shenjin73/microduck-build/working-docs/hardware-open-questions.md

# 硬件待确认清单（HD-1910 / 主板 / 连接板 / 目标 / 资源 / CAD）

日期：2026-09-16
用途：把 `microduck-clone-validation-risk-plan.md` 第 7 节的 6 个问题，变成**可以直接发给
供应商、或自己逐项填答**的清单。每项都写明「为什么需要」与「通过标准」。

> **为什么这份清单重要：** Week 1/2/3 全部卡在这些答案上（Week 0.5 的算力问题已结案）。
> 具体地——**HD-1910 的协议不确定，就不要下单批量电机**；协议没过，后面 10 周全是空中楼阁。

## 回答进度

| 类别 | 项数 | 已确认 | 阻塞的后续阶段 |
|---|---:|---:|---|
| A. HD-1910 供应商问题 | 24 | 0 | **Week 1**（单电机 spike）→ Week 3（BAM 辨识）→ Week 6（runtime） |
| B. 自查决策项 | 5 | 1（B1 主板） | Week 0（边界冻结）、Week 2（MJCF）、Week 8–9（训练） |
| C. 机械 CAD / BOM | 4 | 0 | **Week 2**（机械参数测量） |

---

# A. 发给供应商的问题清单（HD-1910-C001）

> 已从资料图确认的**不用再问**：型号 `HD-1910-C001`、TTL 三线串行总线、电压 `4–8.4V`、
> 堵转 `9kg·cm@4.8V / 12kg·cm@6V`、空载速度 `0.139/0.111 s/60°`、堵转电流
> `1.2A@4.8V / 1.5A@6V`、额定电流 `500/690mA`、重量 `21±2g`、尺寸 `34×20×23mm`、
> PA+Fiber 外壳、双轴金属齿轮。
>
> **缺的是「怎么跟它说话」——协议与寄存器。** 这是 A 部分的全部内容。

## A1. 协议与物理层（5 项）

> 已核实的官方 runtime 事实（供对照）：
> `microduck/duck-control/src/model.rs:12` `NUM_JOINTS = 15`、`:31` `MOUTH_INDEX = 9`、
> `:78` `IMU_DXL_ID = 200`、`:80` `BAUD_RATE = 1_000_000`；
> `bus.rs:18` `use rustypot::servo::dynamixel::xl330::Xl330Controller`、`:27` `READ_ADDR = 124`；
> `deploy/robotd.toml:19` `port = "/dev/ttyS2"`。
>
> **这就是 HD-1910 必须对齐的靶子。**

| # | 问题 | 为什么需要 | 通过标准 |
|---|---|---|---|
| A1.1 | 通信协议是什么？是否为 **Dynamixel Protocol 2.0**？若不是，是 Feetech 自有协议还是别的？给出完整协议文档 | 官方 runtime（`microduck/duck-control/src/bus.rs:18`）写死 `rustypot` 的 `Xl330Controller` + Dynamixel P2。**协议不对，现有 runtime 一行都用不了** | 能拿到**完整协议规范**；或能用 `rustypot` 直接读写（最理想） |
| A1.2 | 波特率范围？是否支持 **1 Mbaud**？ | 官方 runtime 用 `1_000_000` baud（`model.rs:80`；`:91` 注释「3 = 1 Mbps, must agree with BAUD_RATE」） | 支持 1M baud 且稳定 |
| A1.3 | 半双工 UART 的**电气电平**（3.3V / 5V）与**方向控制方式**（自动收发 / 需 GPIO 控制 DE 脚）？ | 决定连接板硬件设计。方向控制方式影响 Linux UART 驱动与抖动 | 电平与主板 IO 兼容；方向控制可确定实现 |
| A1.4 | 是否支持**同步读（sync read）/ 同步写（sync write）/ 批量读（bulk read）**？一次事务最多可覆盖几个 ID？ | 15 个舵机 + IMU 要在 **50 Hz**（20 ms）内完成一轮读写。逐个读必然超时 | 一次 sync/bulk 可覆盖 ≥16 个 ID，且一轮 < 10 ms（留一半余量） |
| A1.5 | ID 与波特率的**配置方式**（寄存器写 / 专用工具 / 拨码）？出厂默认 ID 与波特率？ | 15 个舵机要分配唯一 ID；默认值决定产线流程 | 可软件配置 ID/baud；默认值已知 |

## A2. 寄存器表（6 项）

| # | 问题 | 为什么需要 | 通过标准 |
|---|---|---|---|
| A2.1 | 完整**寄存器地址表**：地址、长度、读写权限、单位、范围、默认值 | runtime 的 `FeetechIo`/`Hd1910Io` 要逐寄存器实现；BAM 辨识也要写 goal position / 读状态 | 拿到完整表；关键寄存器地址可验证 |
| A2.2 | **位置**寄存器：地址、单位（0–4095 计数 / 0–360°）、分辨率（bit）、零点定义、是否支持多圈 | 直接映射到 obs 的 `joint_pos` 与 action target | 分辨率 ≥ 12 bit；每关节可校准到 Microduck 的 `DEFAULT_POSITION` |
| A2.3 | **速度**寄存器：地址、单位（rad/s / step/s / rpm）、是否可读实际速度 | 进入 obs 的 `joint_vel` | 换算误差 < 5–10%，否则要加 DR 或重训 |
| A2.4 | **P / I / D 增益**寄存器：地址、单位、范围、**固件控制律语义**（是否 `PWM = kp × error / divisor`，divisor 是多少） | BAM 控制律依赖固件 kp；仿真必须复现它。XL330 对应 `kp_fw=200.0`、divisor 256、PWM limit 885 | 可写、可读、可复现；I/D 可置 0 或可建模 |
| A2.5 | **最大 PWM / 力矩限制 / 电流限制**寄存器：是否存在？默认值？可写范围？ | BAM 用 `1.75A` 固件限流算可持续扭矩（`kt×1.75A≈0.6405 Nm`）。不知道限流就算不出真实能力 | 有明确限流值且可配置 |
| A2.6 | **加速度 / 目标速度限制 / 内部平滑**：是否存在？`q_target` 是否被内部速率限制？ | BAM 的 STS3215 actuator 有 `q_target_smooth = clamp(q_target, prev ± max_velocity·dt)`。**若 HD-1910 也有，仿真必须模拟，否则控制律是错的** | 明确回答有/无；若有，给出限速参数 |

## A3. 读数与保护（6 项）

| # | 问题 | 为什么需要 | 通过标准 |
|---|---|---|---|
| A3.1 | **电流 / 负载**读数：地址、单位（mA / A / 0–1000 的 load 百分比）、是否 signed | safety、热保护、BAM 辨识都需要 | 可读；单位可标定到安培 |
| A3.2 | **电压**读数：地址、单位、精度 | runtime 的 `voltage_adapt` 与电池映射（`BATTERY_EMPTY_V=6.6`/`FULL_V=8.2`）依赖它 | 可读，或另加 ADC / fuel gauge 方案 |
| A3.3 | **温度**读数：地址、单位、精度；是否有**硬件过温保护**？阈值与恢复条件？ | 小双足很容易热；runtime 需要知道最热电机 | 可读；或有明确的热保护策略 |
| A3.4 | **位置/速度返回延迟**：一次读写往返的典型与最坏耗时（在 1M baud、16 设备下） | 直接决定 50 Hz 能否成立 | **15 舵机 + IMU 一轮读写稳定 < 20 ms** |
| A3.5 | **错误/状态寄存器**：是否有 overload / voltage / temperature / angle-limit 错误位？可清除？ | 需要区分「通信超时」与「电机报错」 | 有可读错误位 |
| A3.6 | **堵转/过载保护逻辑**：触发条件、限流曲线、是否自动恢复、恢复延迟 | datasheet 的堵转电流是峰值；**保护逻辑未知就无法判断行走时会不会掉力** | 给出保护曲线或实测数据 |

## A4. 机械（5 项）

| # | 问题 | 为什么需要 | 通过标准 |
|---|---|---|---|
| A4.1 | **输出轴中心**相对安装面的精确位置（三视图尺寸链）与 **horn 厚度** | 决定关节 frame 是否与 XL330 一致；不一致必须改 MJCF | 尺寸链完整，可算 joint frame |
| A4.2 | **安装孔位**图（孔距、孔径、深度、螺纹规格） | 机械件复用性 | 与现有件比对 |
| A4.3 | **可达角度范围 / 机械限位**（是否有内部限位？能否 360°？） | 超出会撞限位；影响动作空间与 runtime clamp | 给出角度范围；与 Microduck 关节需求比对 |
| A4.4 | **齿隙（backlash）**实测值或规格 | 小舵机齿隙直接破坏 sim2real。`microduck_rl` 有专门的 backlash 变体任务（默认任务不含，见风险计划 §9.5） | 提供数值，或承诺可测 |
| A4.5 | **输出轴径向/轴向间隙、齿轮材质与寿命** | 走路是高频往复负载 | 给出规格或测试数据 |

## A5. 采购与一致性（2 项）

| # | 问题 | 为什么需要 | 通过标准 |
|---|---|---|---|
| A5.1 | `HD-1910-C001` 的 **suffix 含义**？是否有同外壳不同固件的版本？ | 风险计划明确警告：要在 BOM/CAD/MJCF 里固定 suffix，避免买到同尺寸不同固件的货 | 确认 suffix 唯一性，或给出选型规则 |
| A5.2 | **批量一致性**：同一批次内 kp/摩擦/齿隙的离散度？是否提供单机标定数据？ | `21±2g` 意味着 15 个电机的质量离散已达 ±30g；kp/摩擦离散会进 DR | 给出离散度指标；最好能逐台标定 |

> **打包发送建议：** A1–A5 共 24 问，其中 **A1.1（协议文档）、A2.1（寄存器表）、
> A3.4（返回延迟）** 是最关键的三项——**这三项没答案就不能下单**。

## A6. 可直接复制发送的提问稿

> 下面这段是纯文本，可直接粘贴到邮件/微信/询价单。表格适合自己核对，这段适合发给对方。

```text
你好，我们在用 HD-1910-C001 做一个小型双足机器人（15 个舵机 + 1 个 IMU 板共用一条
TTL 总线，1 Mbps，控制回路 50 Hz）。资料图上的机械/电气参数我们已经有了，
现在需要以下技术资料，麻烦逐项回复，谢谢。

【一、协议与物理层】
1. 通信协议是什么？是 Dynamixel Protocol 2.0 吗？如果不是，请提供完整协议文档。
2. 波特率支持哪些？1 Mbps 是否稳定支持？
3. 半双工 UART 的电气电平是多少（3.3V/5V）？方向控制是自动收发，还是需要外部
   GPIO 控制 DE 脚？
4. 是否支持同步读（sync read）/ 同步写（sync write）/ 批量读（bulk read）？
   一次事务最多覆盖多少个 ID？16 个设备一轮读写的典型与最坏耗时是多少？
5. ID 和波特率怎么配置（寄存器写入还是专用工具）？出厂默认 ID 和波特率是多少？

【二、寄存器表】
6. 请提供完整寄存器地址表（地址、长度、读写权限、单位、范围、默认值）。
7. 位置寄存器：地址、单位（0-4095 计数还是 0-360°）、分辨率、零点定义、是否支持多圈？
8. 速度寄存器：地址、单位（rad/s、step/s 还是 rpm）？能否读实际速度？
9. P/I/D 增益寄存器：地址、单位、范围。固件控制律是什么形式
   （例如 PWM = kp × error / divisor）？divisor 是多少？
10. 是否有最大 PWM / 力矩限制 / 电流限制寄存器？默认值和可写范围是多少？
11. 是否有加速度限制或内部目标速度限制（即目标位置是否会被固件内部限速平滑）？
    如果有，限速参数是多少？

【三、读数与保护】
12. 电流/负载读数：地址、单位（mA / A / load 百分比）、是否有符号？
13. 电压读数：地址、单位、精度？
14. 温度读数：地址、单位、精度？是否有硬件过温保护？阈值和恢复条件？
15. 一次读写往返的典型与最坏延迟（1 Mbps、16 设备）？
16. 有哪些错误/状态位（过载、过压、过温、角度超限）？能否清除？
17. 堵转/过载保护的触发条件、限流曲线、是否自动恢复、恢复延迟？

【四、机械】
18. 输出轴中心相对安装面的精确位置（三视图尺寸链）和 horn 厚度？
19. 安装孔位图（孔距、孔径、深度、螺纹规格）？
20. 可达角度范围？是否有内部机械限位？能否 360°？
21. 齿隙（backlash）的实测值或规格？输出轴径向/轴向间隙？
22. 齿轮材质、减速比、寿命指标？

【五、采购一致性】
23. HD-1910-C001 的后缀 C001 是什么含义？是否有同外壳但不同固件的版本？如何区分？
24. 批量一致性：同批次内 kp、摩擦、齿隙的离散度是多少？是否提供逐台标定数据？

其中第 1、6、15 项是我们最急需的——没有协议文档和寄存器表，我们无法开始驱动开发。
如果方便，也请提供推荐的工作电压（我们计划用 2S 锂电，6.6-8.4V）下的性能曲线。
```

---

# B. 自查决策项

这 5 项不需要问别人，是你自己的选择。每项都给出「选项 → 解锁什么 / 代价是什么」。

## B1. 主板型号 ✅ 已定案（2026-09-20）

**已定：Radxa Zero 3W（RK3566）**——官方 MicroDuck 原板，选项 A。板子已到货并点亮
（2GB/无 eMMC/带排针，Armbian 26.8.1 Minimal + vendor 6.1.115 内核基线验证通过，
provisioning 未跑）。选型论证、图像/声音识别对主板的要求、备选型号对比（OPi 3B/5B、
命名陷阱清单）与 bring-up 进展详见 **`working-docs/zero3w-bringup-log.md`**。

## B2. 连接板目标

| 选项 | 说明 |
|---|---|
| **A. 复刻原 Microduck HAT** | 电路已知、风险最低；但需原板资料（可能拿不到） |
| **B. 自己设计电源 + 总线 + IMU/ToF 连接板** | 可控；但必须保障 15 舵机的**供电瞬态**与半双工 UART 1Mbps 稳定性 |

**设计时必须满足**（来自风险计划 §R5）：

- 15 个舵机供电瞬态（额定总电流可达 **10A 级**，`690mA×15`；峰值更高 → 线径/铜箔/电容要按峰值设计）
- 半双工 UART 1 Mbps 稳定（含方向控制时序）
- IMU 更新时间与坐标系
- ONNX 推理**不抢占** 50 Hz 控制回路
- 热管理

## B3. 第一版行为目标（MVP）

计划建议的 MVP（**建议采纳**）：

- [ ] 能站立
- [ ] 能被 gamepad/命令控制前后左右
- [ ] 摔倒后低风险恢复，或至少 limp
- [ ] 能 OTA/ssh 部署新 policy
- [ ] **不强求** soccer / tidy / autonomous vision

**如果第一版就要 camera/ToF/自主行为**：风险计划 §R6 标为「中高风险」——`mediad`/`tofd`/NPU/
camera calibration 全是 board-specific 陷阱，且 `docs/camera-hardware.md` 显示仅 FOV/分辨率/
畸变就能显著影响 tidy/soccer 行为。建议先做机械预留 + 软件 stub。

## B4. 训练资源

**已在 Week 0.5 用数字定案**（见 `apple-silicon-throughput-benchmark.md`），所以这项现在只是选择：

| 路线 | 成本 | 3.9 亿步耗时 | 定位 |
|---|---:|---:|---|
| **A. 云 NVIDIA + 官方 `microduck_rl`** | ~$2–4 / 次 | ~1.5 h | 保真度基准 |
| **B. Mac + `microduck_local` 过夜** | 电费 ~0 | ~5.8 h | 零成本 MVP |

**建议：先 B 后 A。** B 路需先补 3 个 obs 级 DR 缺口（IMU 安装误差 ±6°、编码器 bias
±0.015 rad、IMU 延迟 0–1 步）。注意两栈 step 数**不等价**（batch 差 12 倍）。

## B5. 是否保持 15 舵机（mouth 不进 policy）

**建议保持**：真机 runtime 是 15 个舵机（`model.rs:12` `NUM_JOINTS = 15`），但
**policy action 只有 14 维，`MOUTH_INDEX = 9` 不在其中**（`model.rs:31`）。这是 61→14 contract
的一部分，改了就要改 policy 接口——**风险计划 §R7 明令不要动**。

---

# C. 机械 CAD / BOM（Week 2 的输入）

| # | 问题 | 为什么需要 | 通过标准 |
|---|---|---|---|
| C1 | 是否已有 clone 的 **CAD / BOM**？ | Week 2 全部工作建立在它之上 | 有可编辑的 CAD + 完整 BOM |
| C2 | 能否导出**每个部件的质量**？ | 总质量差 > 5% 就必须改 MJCF | 逐件质量表（实测，非估算） |
| C3 | 能否导出**惯量**？ | `microduck_local` 的 DR 只覆盖 ±5%；超了必须改 MJCF | 逐件惯量或可计算的几何+密度 |
| C4 | 能否导出 **joint frames / 关节零点与限位**？ | 关节 frame 变则整套 MJCF 要改 | 每个关节的 frame 定义与限速范围 |

**建议产出**（计划 Week 2 的最小交付）：`working-docs/clone-mjcf-delta.csv`

```text
part, original_mass_g, clone_mass_g, delta_g, com_delta_mm, action
left_hip_servo, ..., ..., ..., ..., update inertial
battery,        ..., ..., ..., ..., update trunk mass/com
```

**判断规则**（来自计划 Week 2）：

- 总质量差 **> 5%** → 必须更新 MJCF
- trunk/head CoM 差 **> 5–10 mm** → 必须更新 MJCF/DR
- servo 惯量或齿轮比明显不同 → 必须改 actuator model
- 关节限位不同 → 必须更新 XML + runtime clamp

---

# D. 这些答案分别解锁什么

| 答案 | 解锁 | 没答案会怎样 |
|---|---|---|
| **A1.1 协议文档** | Week 1 单电机 spike → Week 3 BAM 辨识 → Week 6 `FeetechIo` | **全流程阻塞**；不知协议连一个电机都驱动不了 |
| A2.1 寄存器表 | 同上 + runtime 读写实现 | 同上 |
| A3.4 返回延迟 | 50 Hz 可行性判定 | 可能做完连接板才发现总线跑不动 50 Hz |
| A2.4 P 增益语义 | BAM `kp_fw` 标定 | 仿真与真机行为不匹配 |
| A2.6 内部速率限制 | actuator 模型正确性 | 控制律是错的（仍在模仿 XL330） |
| B1 主板 | Week 6 runtime 适配范围 | 无法估工时 |
| B2 连接板 | 硬件设计启动 | 电机到了也没法供电/通信 |
| B3 MVP 目标 | Week 0 边界冻结 | 范围蔓延；第一版永远做不完 |
| B4 训练资源 | Week 8–9 路线 | 已定案，只需选择 |
| C1–C4 CAD/BOM | Week 2 机械测量 | MJCF 无法核对，机械风险不可控 |

## 建议的执行顺序

```text
1. 立刻发 A 部分给供应商（24 问）           ← 唯一能并行做、且决定后续一切的
2. 同时填 B1–B5（自查，一天内可完成）
3. A1.1 + A2.1 + A3.4 到手后 → 买 1 个电机做 Week 1 spike
4. spike 通过 → 再下单批量（避免买了 15 个不能用）
5. C 部分与 Week 1 并行推进（若 CAD 已有）
```

> **红线：** 参照 Week 0.5 的教训（先测数字再下单），
> **HD-1910 的协议与 50 Hz 预算没验证前，不要批量采购电机、不要投连接板批量。**

---

## 相关文档

- `microduck-clone-validation-risk-plan.md` — 风险清单 R1–R8、10 周计划（Week 0.5 已结案）
- `apple-silicon-throughput-benchmark.md` — 算力实测与 Go/No-Go（含附录 A 修正记录）
- `custom-motor-guide.md` — 换电机的操作流程（12 条修正，已实测验证）
