shenjin73/microduck-build/docs/decisions.md

# 决策日志

每个决定的**理由**、**置信度**、以及**什么情况会推翻它**。
六周后你会想知道"当初为什么这么定" —— 这份文件就是答案。

格式：日期 · 决定 · 为什么 · 置信度 · 什么会推翻它。

---

## 2026-09-15 · 选飞特 HD-1910-C001 作为 XL330 的替代

**决定**：用 15 颗飞特 HD-1910-C001 替代 Dynamixel XL330-M288-T。

**为什么**：在三个候选里，它是唯一一个让结果**还是同一只鸭子**的。

| | **HD-1910-C001** ⭐ | 飞特 STS3215 | 宇树 S288 |
|---|---|---|---|
| 电压 | **4–8.4 V（2S 原生匹配）** | 7.4 V | 12.6 V（要改 3S） |
| 重量 | 21±2 g | 55–60 g | 19.5 g |
| 堵转 | 1.47 N·m @7.4V | 1.86 N·m | 0.6 N·m @12.6V |
| 机械 | 需改件 | 整机重做 | 尺寸几乎相同 |
| 净效果 | 整机 737 → ~782 g（+6%） | 变成 2.1 kg / 42 cm 的别的东西 | 供电系统重做 |

另外两条：

- ✅ **电压是优势而非妥协**：XL330 是被 Pollen 超压运行的（额定 3.7–6.0 V，实跑 6.6–8.2 V）；
  HD-1910 的 4–8.4 V **完整覆盖 2S 带载区间**，在厂商额定内工作。
- ⚠️ **电流要重算**：堵转 2.0 A vs XL330 约 1.5 A → 15 颗 **30 A** vs 22.5 A。
  官方 HAT 每个舵机接口旁注 **「3A max」**。

**数据来源（重要 —— 请连同置信度一起读）**：

这些数字**不是**来自官方仓库（官方仓库关于电机的词汇只有 `XL330` / `XL330-M288-T` / `XL330s`），
也**不是**来自厂商原始规格书。来源是第三方复刻仓库
[`fanhao375/microduck-replica`](https://github.com/fanhao375/microduck-replica) 的
`docs/硬件方案逆向.md`，它自己标注的数据源是：

> 《HD-1910-C001 串型规格书》A/0，**2026-09-07 初次发行**（厂家发给客户确认的文档，该仓库按惯例不转载 PDF）

也就是说：**这是"第三方读厂商 PDF"的结果，不是"我们读了厂商 PDF"。**

**置信度：中。** 分项：

| 项 | 置信度 | 依据 |
|---|---|---|
| 机械上要改件（压腿处） | **高** | 社区**实测** —— 他们真的装了 15 颗并重打了结构件 |
| 2.0 mm 线序与 Dynamixel 相反 | **高** | 同上，实测 |
| 过流/过压保护出厂关闭 | **高** | 社区装机记录 |
| 4–8.4 V | ⚠️ **中** | 二手解读 |
| 1.47 N·m 堵转 | ⚠️ **中** | 同上，且注明产品页保守值 10 kg·cm 曾被更正 |
| 1/320 减速比、≤0.5° 回差 | ⚠️ **中** | 同上 |

**什么会推翻它**：

- 电压区间不是 4–8.4 V → 若是 5–7.4 V，2S 满电 8.4 V 就超压了，选型的整个地基没了
- 额定负载力矩远低于预期 → **注意堵转 1.47 与额定 0.363 N·m 差 4 倍**，训练时的力矩模型用哪个是天壤之别
- 出厂运行模式不是"模式 4 纯位置 PD" → 通信层要多一层配置

**行动项**：`[ ]` 下单前向飞特索取原始规格书，自己核上面三个数。

---

## 2026-09-15 · 不移动三个上游 checkout

**决定**：`microduck` / `microduck-lab` / `microduck_rl` 留在原地，**不**收进 `upstream/` 子目录。

**为什么**：`microduck_local` 按**兄弟目录**找模型，是硬编码的相对路径：

```python
# walk_env.py
scene = Path(scene_xml) if scene_xml else C.SCENE_WALK_XML
if not scene.exists():
    raise FileNotFoundError("... clone microduck_rl next to microduck_local ...")
```

而 `microduck-lab` 自己的约定就是"**四个并排的 checkout**"。移动它们会直接破坏运行。

**置信度：高**（代码可查）。
**什么会推翻它**：上游改了目录约定 —— 那时跟着改。

> **2026-09-20 补记：本条已部分修订，见下条。** 约束本身仍然成立，但适用范围被收窄了 ——
> 它约束的是 `microduck-lab` **内部**那四份并排 checkout 的相互位置，不是它们所在的父目录。

---

## 2026-09-20 · 三个上游 checkout 收进 `reference/`

**决定**：`microduck-lab` / `microduck-replica` / `elec_RPI_Robot_HAT` 移到 `reference/` 下。

**为什么安全**：上条的约束是"**四份并排的 checkout 不能拆开**"，而不是"父目录不能动"。关键事实是
`microduck_rl` 和 `microduck` 都在 `microduck-lab/` **里面**，不在它旁边：

```
microduck-lab/
├── microduck_local/   ← lab 自己跟踪
├── microduck_rl/      ← 嵌套独立 repo（lab 已忽略）
├── microduck/         ← 嵌套独立 repo（lab 已忽略）
└── duck-viewer/
```

所以代码里的 `../microduck_rl`（相对 cwd）和 `parents[3] / "microduck_rl"`（相对文件位置）
**只依赖 `microduck-lab` 内部的相对层级，不依赖父目录叫什么名字**。整体移动 `microduck-lab/`
不会改变任何一对相对位置。上条防的是"只把 `microduck_rl/` 挪走"这类拆散操作。

**同时做了**：`microduck-lab` 从 submodule 改为**普通本地副本**，与 `microduck-replica` /
`elec_RPI_Robot_HAT` 统一。做法是把 `.git/modules/microduck-lab` 搬成
`reference/microduck-lab/.git`，并清掉残留的 `core.worktree`。三者现在都是自包含克隆，
`reference/` 整体被 gitignore。

**代价**：失去 submodule 的版本锁定 —— clone 本仓库的人不会自动拿到这三个 checkout。
考虑到它们的角色是**只读参考、不参与构建**，这个代价可以接受。

**连带更新**：69 处路径引用（含 3 个会真正执行的 shell 脚本）。

**置信度：高**（相对路径行为已实测）。
**什么会推翻它**：上游把四份 checkout 的约定改成"必须并排在某个固定父目录下"。

---

## 2026-09-15 · 文档独立成 repo，不放进任何 clone

**决定**：路线图、决策日志、台架记录放在 `~/Projects/microduck-build/`，**不放进** `microduck` 或 `reference/microduck-lab`。

**为什么**：

1. 它是**我们自己的项目计划**，不是任何一个上游仓库的内容
2. 它要活几个月，会不断改；放在 clone 里，每次 `git pull` 都可能冲突
3. 它要自己的历史（这份 decisions.md 的意义就在这）
4. 它**凌驾于三个仓库之上**，要同时引用它们的路径和版本
5. 台架数据、对比图、训练产物**不该提交进别人的仓库**

**置信度：高。**
**什么会推翻它**：如果决定把部分内容上游贡献，那一部分单独开分支走 PR。

---

## 2026-09-15 · `parts-list.md` 留在官方仓库，暂不拆分

**决定**：`~/Projects/microduck/docs/robot/parts-list.md` 原位保留（未提交，`git status` 显示 `??`）。
**不在** `microduck-build` 里放副本，避免两份分叉。

**为什么**：它是一份用仓库自己的双语风格写、已挂进 `docs/README.md` 索引的**正经文档贡献** ——
官方仓库确实没有 BoM，这个补位有价值，值得走 PR。

**但有一个已知问题**：里面有**大段淘宝采购链接**（第三方 2026-09-04 快照），上游很可能不收。
现实的分法是：

- **上游可收**：型号、依据文件、总线分类、避坑 → 开分支提 PR
- **采购链接**：挪到本项目自己留着

**置信度：中**（取决于是否真的要走 PR）。
**行动项**：`[ ]` 决定是否提 PR；若提，先按上面拆分。

---

## 2026-09-15 · 补上 `parts-list.md` 的来源标注

**决定**：把第 2 节「替代型号」里 HD-1910 的来源说明**改具体**。

**为什么**：现在那里只写了"社区对飞特规格书的解读"，不够 ——
应具体到「`microduck-replica` 的 `docs/硬件方案逆向.md`，读的是 2026-09-07 首发的
《HD-1910-C001 串型规格书》A/0」，并加一句"这三个数字请自行向厂商核对"。

**置信度：高。**
**行动项**：`[ ]` 执行。
