shenjin73/microduck-build/docs/bench/registers-2026-09-26.md

# HD-1910-C001 寄存器底账（ID 1，出厂状态，4.5V USB 供电，2026-09-26）

| 地址 | 名称 | 区 | 值 |
|---|---|---|---|
| 0 | 固件主版本 | 只读 | 3 |
| 1 | 固件次版本 | 只读 | 46 |
| 2 | END 字节序(0=小端) | 只读 | 0 |
| 3 | 舵机主版本 | 只读 | 10 |
| 4 | 舵机次版本 | 只读 | 31 |
| 5 | ID | EEPROM | 1 |
| 6 | 波特率(0=1M) | EEPROM | 0 |
| 7 | 预留/应答延时 | EEPROM | 253 |
| 8 | 应答状态级别 | EEPROM | 1 |
| 9 | 最小角度限制 | EEPROM | 0 |
| 11 | 最大角度限制 | EEPROM | 4095 |
| 13 | 最高温度上限 | EEPROM | 80 |
| 14 | 最高输入电压 | EEPROM | 100 |
| 15 | 最低输入电压 | EEPROM | 40 |
| 16 | 最大扭矩 | EEPROM | 1000 |
| 18 | 相位 | EEPROM | 52 |
| 19 | 卸载条件 | EEPROM | 4 |
| 20 | LED报警条件 | EEPROM | 4 |
| 21 | 位置环P | EEPROM | 32 |
| 22 | 位置环D | EEPROM | 40 |
| 23 | 位置环I | EEPROM | 0 |
| 24 | 最小启动扭矩 | EEPROM | 12 |
| 25 | 积分限制值 | EEPROM | 0 |
| 26 | 正向不灵敏区 | EEPROM | 1 |
| 27 | 负向不灵敏区 | EEPROM | 1 |
| 28 | 保护电流 | EEPROM | 500 |
| 30 | 角度分辨率 | EEPROM | 1 |
| 31 | 位置偏移 | EEPROM | 0 |
| 33 | 运行模式 | EEPROM | 4 |
| 34 | 保持扭矩 | EEPROM | 200 |
| 35 | 保护时间 | EEPROM | 50 |
| 36 | 过载扭矩 | EEPROM | 255 |
| 37 | 速度环P | EEPROM | 60 |
| 38 | 过流保护时间 | EEPROM | 200 |
| 39 | 速度环I | EEPROM | 20 |
| 40 | 扭矩开关 | SRAM | 1 |
| 41 | 加速度 | SRAM | 50 |
| 42 | 目标位置 | SRAM | 1023 |
| 44 | PWM开环速度 | SRAM | 0 |
| 46 | 运行速度 | SRAM | 1000 |
| 48 | 转矩限制 | SRAM | 1000 |
| 55 | 锁标志 | SRAM | 1 |
| 56 | 当前位置 | 反馈 | 1022 |
| 58 | 当前速度 | 反馈 | 0 |
| 60 | 当前负载 | 反馈 | 0 |
| 62 | 当前电压(0.1V) | 反馈 | 46 |
| 63 | 当前温度(°C) | 反馈 | 33 |
| 64 | 异步写标志 | 反馈 | 0 |
| 65 | 舵机状态位 | 反馈 | 0 |
| 66 | 移动标志 | 反馈 | 0 |
| 67 | 目标位置(回读) | 反馈 | 1023 |
| 69 | 当前电流(6.5mA) | 反馈 | 32769 |
| 80 | 移动速度阀值 | 出厂 | 1 |
| 81 | DTs(ms) | 出厂 | 10 |
| 82 | 速度单位系数 | 出厂 | 60 |
| 83 | 最小速度限制 | 出厂 | 20 |
| 84 | 最大速度限制 | 出厂 | 0 |
| 85 | 加速度限制 | 出厂 | 0 |
| 86 | 加速度倍数 | 出厂 | 0 |
