shenjin73/microduck-build/working-docs/board-photos/HAT_back_annotated.jpg

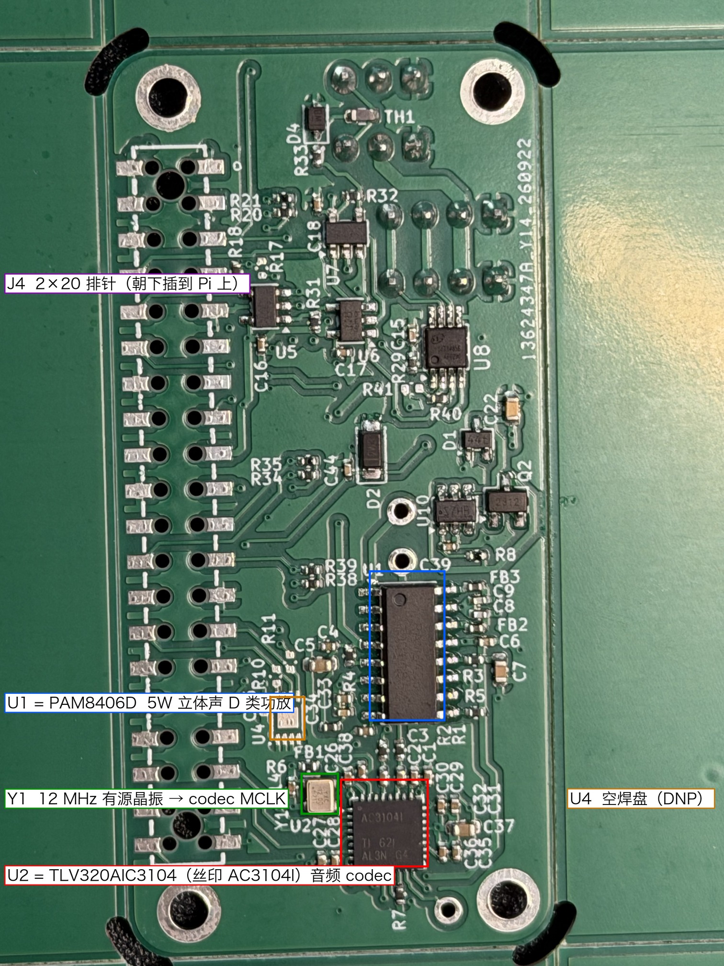
working-docs/board-photos/HAT_back_annotated.jpg
