shenjin73/microduck-build/working-docs/board-photos/HAT_front_annotated.jpg

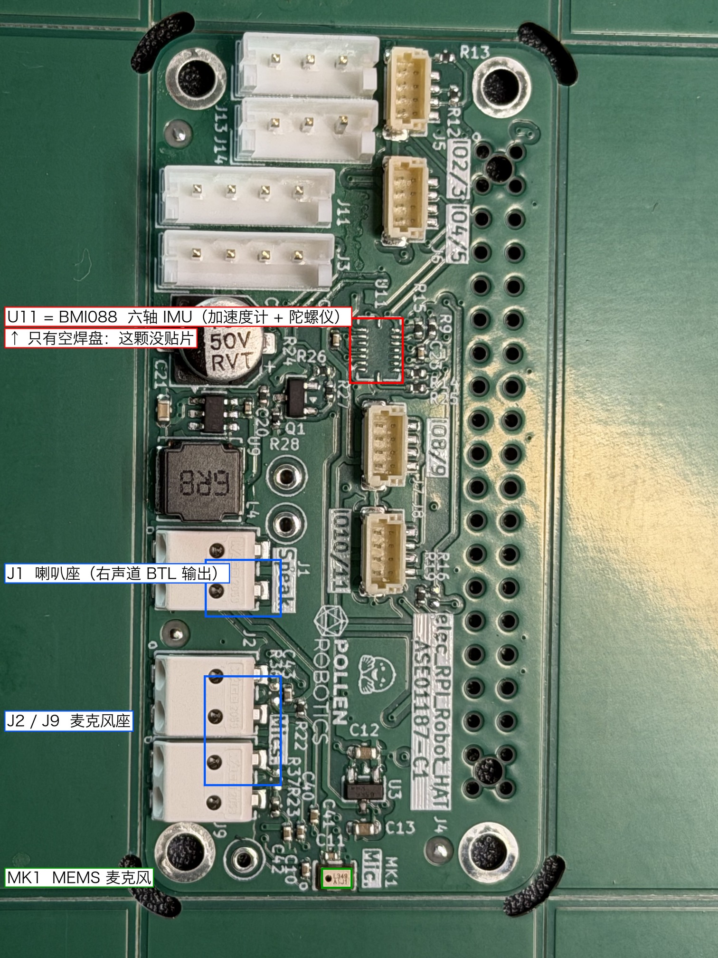
working-docs/board-photos/HAT_front_annotated.jpg
