shenjin73/microduck-build/working-docs/board-photos/HAT_on_Radxa_annotated.jpg

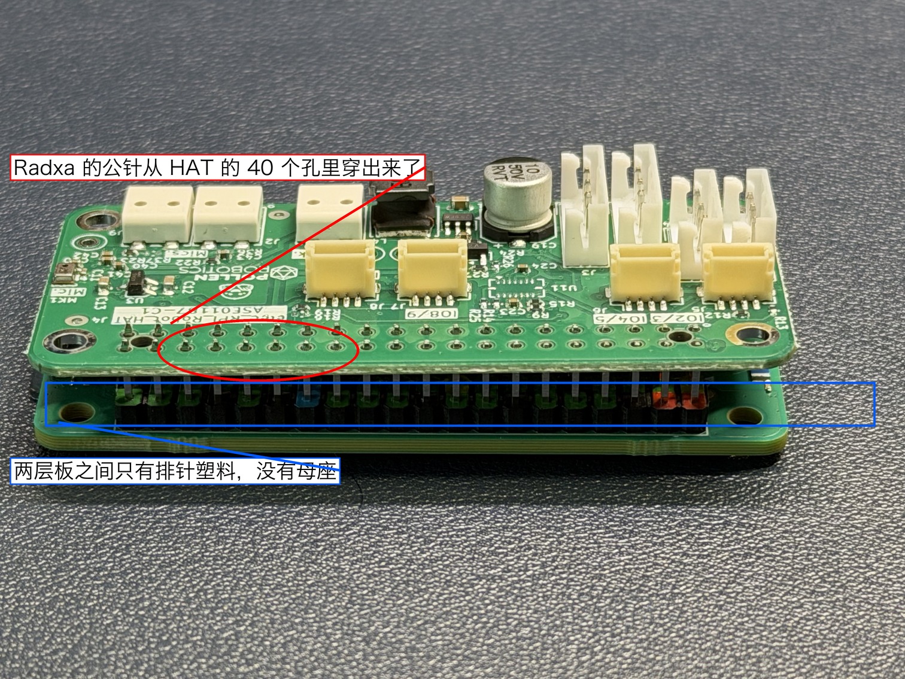
working-docs/board-photos/HAT_on_Radxa_annotated.jpg
