shenjin73/microduck-build/working-docs/board-photos/J4_socket_C2685112.jpg

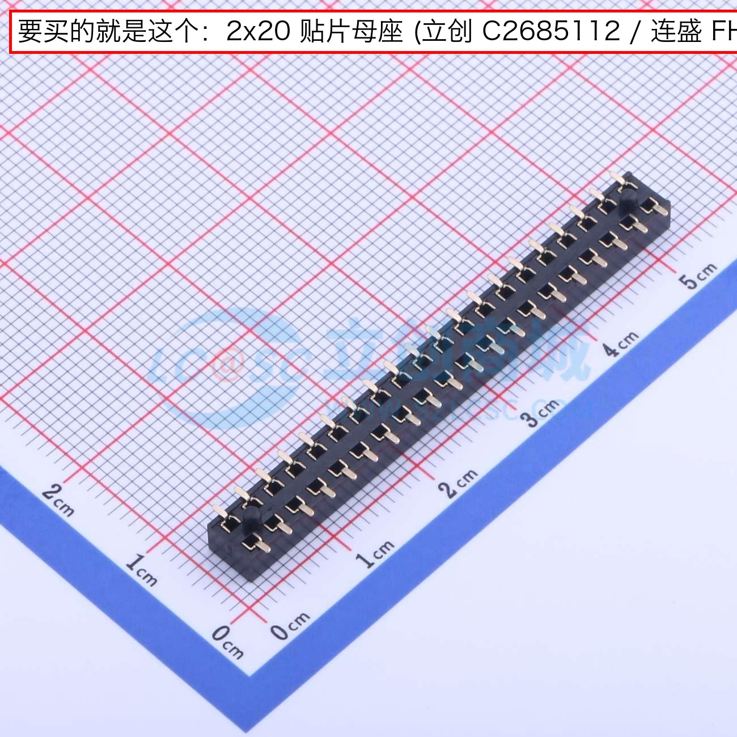
working-docs/board-photos/J4_socket_C2685112.jpg
