shenjin73/microduck-build/working-docs/npf550-battery-holder/demo_frame.png

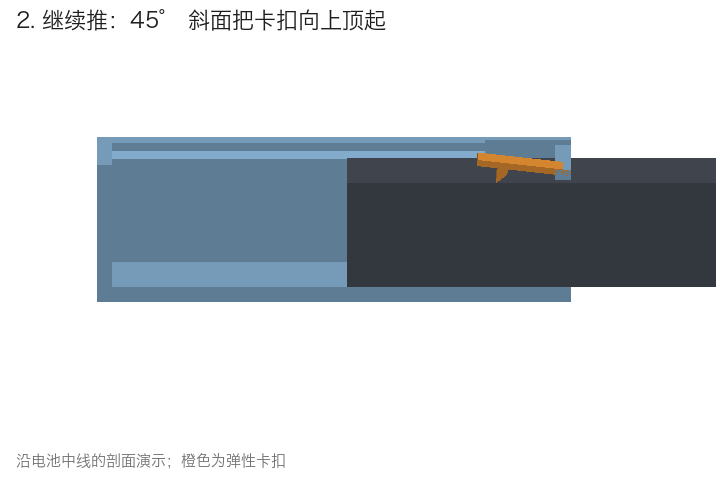
working-docs/npf550-battery-holder/demo_frame.png
