shenjin73/microduck-build/working-docs/npf550-battery-holder/demo_frame_locked.png

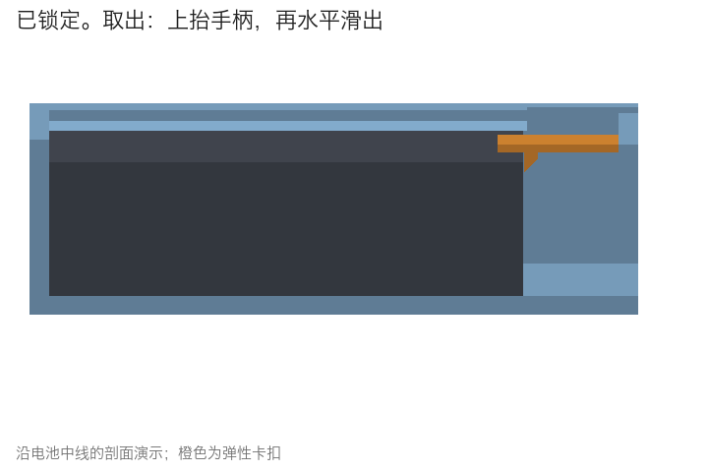
working-docs/npf550-battery-holder/demo_frame_locked.png
