shenjin73/microduck-build/working-docs/npf550-battery-holder/insert_demo.gif

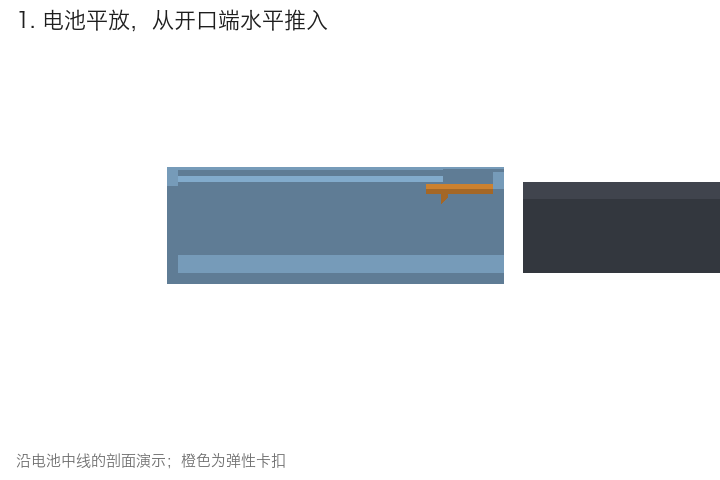
working-docs/npf550-battery-holder/insert_demo.gif
