shenjin73/microduck-build/working-docs/npf550-battery-holder/preview.png

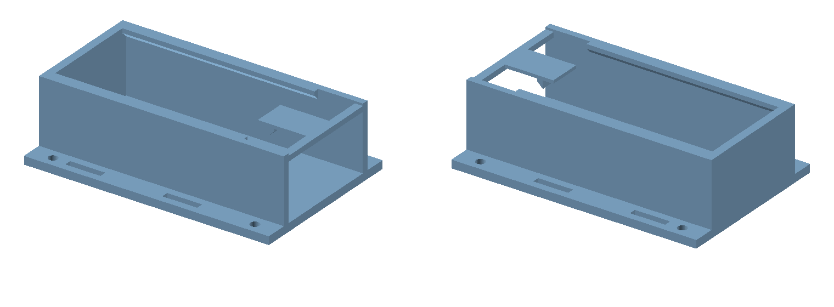
working-docs/npf550-battery-holder/preview.png
