shenjin73/microduck-build/working-docs/hardware-shopping-list.md

# Microduck 复刻 · 硬件采购清单（飞特路线）

日期：2026-09-20
路线：Radxa Zero 3W + 飞特 HD-1910 ×15（机械/装配照抄 fanhao375/microduck-replica）
来源：价格与链接主要来自 `microduck-replica/docs/电控采购清单.md`、`机械采购清单.md`
（**2026-09-04 淘宝快照**，下单前自己核价；链接失效就按关键词重搜）。

> **红线不变：Week 1 spike 通过前，只持有 1 颗舵机，不批量下单。**

---

## 0. 已购 ✅

| 项 | 配置 | 价格 | 渠道 |
|---|---|---:|---|
| 主控 Radxa Zero 3W | 2GB / 无 eMMC / 带排针 | ~¥200+ | 京东 |
| 飞特 HD-1910-C001 | ×1（验证用） | — | 在途 |
| FE-URT-2 调试板 | USB 转 TTL | ~¥45 | 在途 |
| 64GB microSD（A2） | 启动介质 | ~¥40 | 已有 |

## 1. 舵机（占成本大头，spike 后再补）

| 项 | 数量 | 单价参考 | 小计 | 备注 |
|---|---:|---:|---:|---|
| 飞特 HD-1910-C001 | **再补 14** | ~¥50–70 | **~¥700–1000** | 固定 suffix `C001`，同批购买；供应商 24 问（`hardware-open-questions.md` A6）已备 |
| 5264-3P 舵机延长线 | 20+ 根（多长度） | ¥1.8–2.5 | ~¥50 | [松甲科技 ¥2/根](https://item.taobao.com/item.htm?id=587191439333)、[飞特工厂店 ¥1.8](https://item.taobao.com/item.htm?id=616460581906)；⚠️ 是 **5264** 不是 JST EH（都是 2.5mm 间距但壳体不同，到手试插） |

## 2. 电控 · 必买

| 项 | 规格 | 价格 | 渠道 | 备注 |
|---|---|---:|---|---|
| 摄像头 | IMX219 通用模组 | **¥32.8** | [DECXIN 天猫](https://detail.tmall.com/item.htm?id=775872575316) | 别买瑞莎官方版 ¥130 |
| CSI 排线 | 15P→22P 转接，**4–15cm 短版** | **¥1.88–2.5** | [汇博视捷 4cm ¥1.88](https://item.taobao.com/item.htm?id=654755002992) | 相机和主控同在头部，排线不过脖子 |
| ToF | **VL53L8CX** 模块 | **¥70–85** | [都会明武 ¥75](https://item.taobao.com/item.htm?id=942554129061) | ⚠️ 别买成 VL53L0X（单点）/ L7CX |
| 电池 | **NP-F550**（2S 7.4V） | **¥52.8** | 淘宝搜「唯卓仕 NP-F550」 | ⚠️ 是 F550 不是 F970（装不进去且 300g） |
| NP-F 电池扣板/仓 | 取电用 | **¥17.8–19** | [腾壶 ¥17.8](https://detail.tmall.com/item.htm?id=658975825526) / [拓普赛 ¥19](https://detail.tmall.com/item.htm?id=926961598924) | 官方只有打印支架，触点方案靠它 |
| UBEC 降压 | 5V/3A，输入下限 ≤6V | **¥10–15** | 淘宝搜「UBEC 5V 3A 2S」 | 给主控供电；别买 LM2596；输入并 470µF/16V 电容 |
| 半双工总线转接板 | 飞特 ST/SC TTL 驱动板 | **¥22–26** | [Fashion脖子 ¥22](https://item.taobao.com/item.htm?id=1005305041207) / [灵影 ¥26](https://item.taobao.com/item.htm?id=983866781632) | 见 §4 HAT 决策 |

## 3. 电控 · 打样（两块板）

| 板 | 方案 | 价格量级 | 备注 |
|---|---|---:|---|
| **imu_to_dxl** | 自绘打样（replica 已逆向：STM32G031 + LSM6DSV16X） | **¥25–40**（2 层板，嘉立创，不含贴片）+ 贴片 | IMU 伪装成总线从机 ID 200；打样前过一遍 replica 电控清单里的 8 条改版意见（C6 耐压 25V、C5 4.7µF、JST EH vs 5264 试插等） |
| **RPI Robot HAT** | 二选一，见 §4 | ¥0 或 数百 | |

## 4. 决策点：HAT 打样 vs 模块拼装

| | A. 官方 Gerber 打样 | B. 模块拼装（推荐先走） |
|---|---|---|
| 内容 | [elec_RPI_Robot_HAT](https://github.com/pollen-robotics/elec_RPI_Robot_HAT) 直接送厂：4 层板 65×30.9mm、113 贴装位、必须 SMT | ¥22 半双工转接板（总线）+ UBEC（配电）+ ToF 直挂 i2c3 |
| 成本 | 数百元 + 起订量 | **~¥50** |
| 得到 | 板载音频（TLV320AIC3104 + PAM8406 功放 + MEMS 麦）、Qwiic 座、整洁 | 舵机总线 + 供电两件必需功能 |
| 失去 | — | **板载音频** → 过渡方案：MAX98357A I²S 功放模块（~¥5）+ 5W 小喇叭（~¥10）+ USB 麦克风（~¥20）先验证出声/录音 |
| 建议 | 鸭子走稳、要量产音频时再打 | **第一只鸭子走这条** |

## 5. 机械 · 必买

| 项 | 规格/数量 | 价格 | 渠道 |
|---|---|---:|---|
| 轴承 | Ø22×16×4 **×11** + Ø15×10×3 **×3** | ~¥40 | [鑫燚一站购齐 ¥5/颗](https://item.taobao.com/item.htm?id=670727787832)；或 NBZH ¥2.2 |
| 螺丝套装 | M2 主力 600pcs（M2/M2.5/M3 组合，含 M2！） | **¥26.8** | [广州信邦](https://item.taobao.com/item.htm?id=842110292995) |
| 热熔螺母 | M2+M3 400pcs | **¥22** | [榕誉微](https://item.taobao.com/item.htm?id=1000673642588) |
| 热熔压头 | M2–M8，配 936/T12 烙铁 | **¥13** | [烙铁工具店](https://item.taobao.com/item.htm?id=902798112263) |
| 螺纹胶 | 乐泰 243 中强度 | **¥19** | [乐泰旗舰店](https://detail.tmall.com/item.htm?id=653848839737)（低于 ¥15 防假） |
| 打印耗材 | PLA/PETG 300–500g + TPU 少量 | ~¥50 | 自有打印机则只算材料 |
| 打印件 | 30 种 / 41 件（replica `print/`，飞特版 8 个配合件要改） | 代打 ~¥100–200 | 拓竹 MakerWorld 有一键打印；**仿真 STL ≠ 工程件**，配合件用 replica-cad 的 SolidWorks 修正版 |
| 轮滑变体（可选） | 15 件：`tire`×8 + `rim`×4 + `roller_blade`×2 + 加高脚踝×2（46.5mm，与标准件不通用） | ~¥20（耗材） | 纯机械件，轮子被动无电子件；`tire` 必须 **TPU** 软料；策略用官方 `roller.onnx`/`roller_crouch.onnx`（飞特路线需重训） |

## 6. 工具（没有才买）

万用表（必）、电烙铁+焊锡、热缩管/热熔胶、USB 键盘（已用显示器排障过一次）。

## 7. 明确不买

- ❌ Raspberry Pi 全系（生态不兼容，见 `zero3w-bringup-log.md` 选型）
- ❌ Orange Pi Zero 3 / Zero 3W（全志芯，命名陷阱）
- ❌ 瑞莎官方摄像头（¥130，通用 IMX219 ¥33 即可）、套餐里的 SD 卡/HDMI 线/电源
- ❌ NP-F970 电池、VL53L0X/L7CX、LM2596 降压
- ❌ 第二块 Zero 3W（备板等鸭子会走再说）

## 8. 预算汇总（第一只鸭子）

| 类别 | 金额 |
|---|---:|
| 舵机 ×14（补）+ 线材 | ¥750–1050 |
| 电控必买（相机/ToF/电池/电源/转接板） | ~¥230 |
| imu_to_dxl 打样 + 贴片 | ~¥100–200 |
| 音频过渡（MAX98357A + 喇叭 + USB 麦） | ~¥35 |
| 机械（轴承/紧固件/耗材/打印） | ~¥250–350 |
| **合计（不含已购 ~¥300）** | **约 ¥1400–1900** |

对比：XL330 原版路线仅 15 颗舵机就要 $359+（~¥2600）。飞特路线整机预算约为原版的 **1/2 到 2/3**。

## 9. 下单顺序

```text
第一批（现在）：舵机线、UBEC、转接板、IMX219+排线、NP-F 扣板+电池
   → 舵机到货后 Week 1 spike 立刻能全套开测
第二批（spike 通过后）：14 颗 HD-1910（同批）
第三批（机械启动后）：轴承/螺丝/热熔螺母/压头/螺纹胶 + 打印件
第四批（走稳之后）：imu_to_dxl 打样；HAT 或音频模块按 §4 决策
```
