shenjin73/microduck-build/working-docs/npf550-battery-holder/contact_template.stl

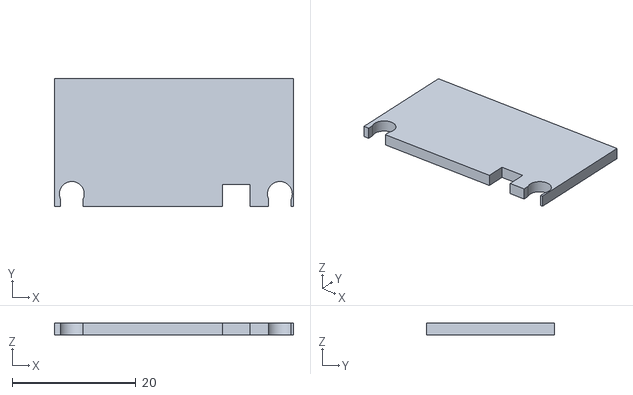
[picture p12: CAD file, 2026-10-25]
working-docs/npf550-battery-holder/contact_template.stl
38.6 x 20.6 x 2.00
