shenjin73/microduck-build/working-docs/npf550-battery-holder/npf550_holder.stl

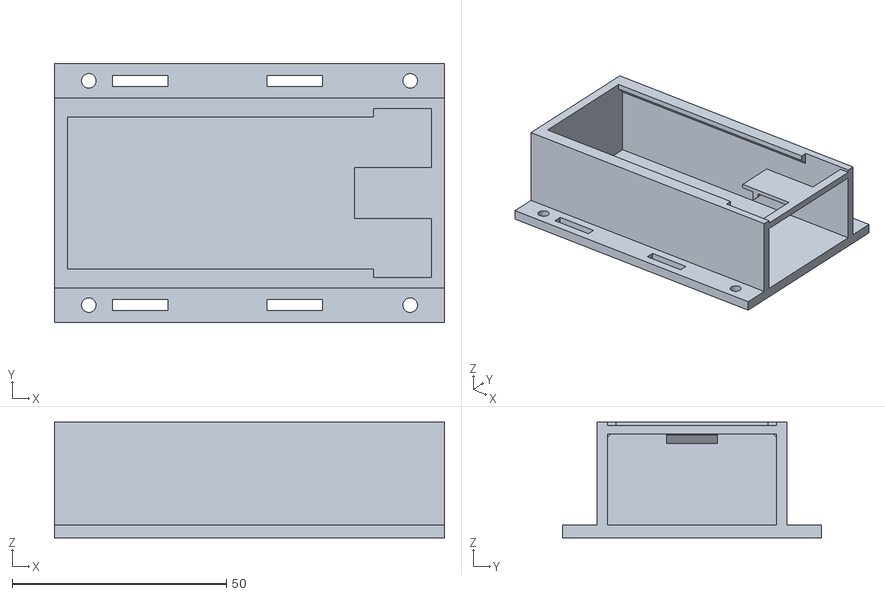
[picture p13: CAD file, 2026-10-25]
working-docs/npf550-battery-holder/npf550_holder.stl
90.9 x 60.3 x 27.0
