shenjin73/microduck-build/working-docs/products/radxa-zero-3w/radxa_zero_3w_schematic_v1.11_20250116.pdf

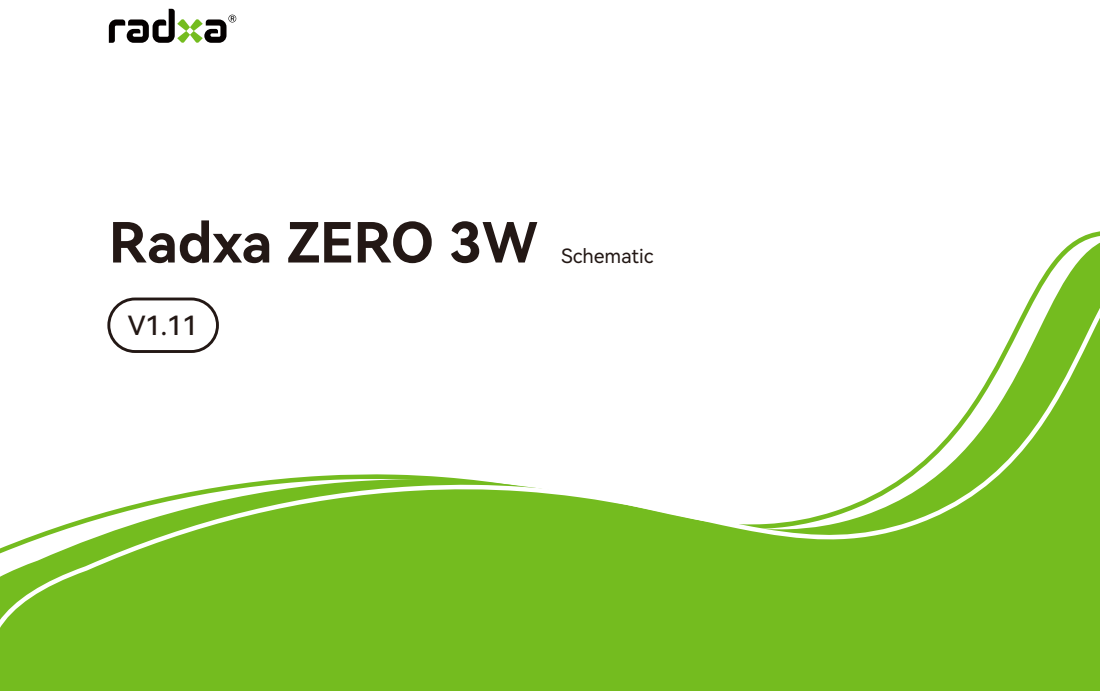
[picture p52: page 1]
Radxa ZERO 3W; Schematic

# 01.cover 02.Index

03.Block Diagram 04.RK3566_SARADC/GPIO 05.RK3566_USB/PCIe/SATA PHY 06.RK3566_OSC/PLL/PMUIO 07.RK3566_Power/GND 08.RK3566_DDR PHY 09.RK3566_VI Interface 10.RK3566_VO Interface_1 11.RK3566_VO Interface_2 12.RK3566_Audio Interface 13.RK3566_Flash/SD 14.LPDDR4_1X32bit 15.SPI Flash/eMMC 16.MicroSD Card 17.TYPEC_USB3.0 18.HDMI2.0 TX 19.WIFI/BT-SDIO 20.CONNECTOR 21.Power_PMIC 22.Power_DC IN; Size; REV; Date:; Sheet; Title:; Page Name:; Index; Zero 3W; Thursday, September 21, 2023; 22 Size

Table of Content

# 5V DC IN

RK817-5

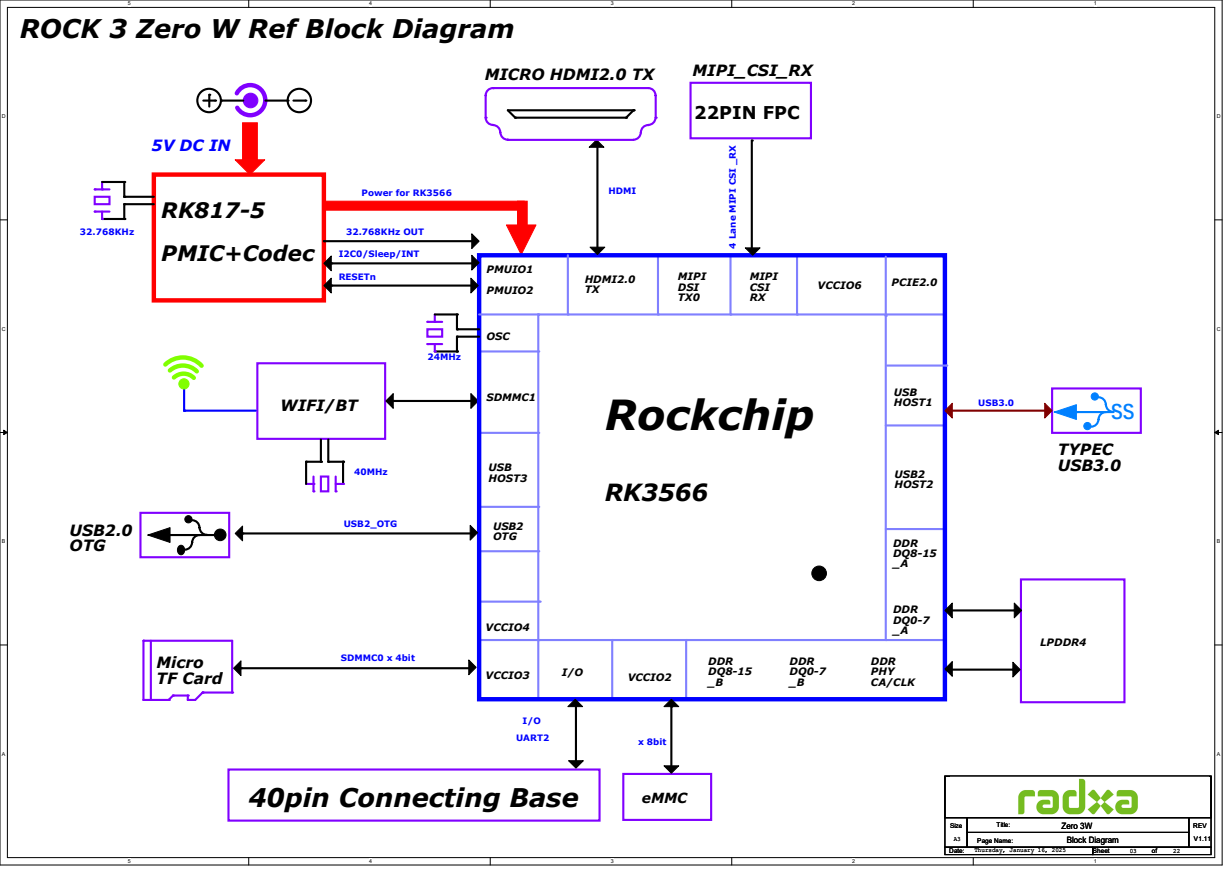
[picture p53: page 3]
SDMMC0 x 4bit; PMIC+Codec; 32.768KHz; Power for RK3566; WIFI/BT; USB2_OTG; Micro TF Card; eMMC; UART2; LPDDR4; HDMI2.0 TX; MICRO HDMI2.0 TX; Rockchip; MIPI DSI TX0; MIPI CSI RX; VCCIO6; PMUIO1; PMUIO2; OSC; SDMMC1; USB2 OTG; VCCIO3; VCCIO4; VCCIO2; DDR DQ8-15 _B; DDR DQ0-7 _B; DDR PHY CA/CLK; DDR DQ0-7 _A; DDR DQ8-15 _A; USB2 HOST2; HDMI; 24MHz; USB HOST3; 32.768KHz OUT; I2C0/Sleep/INT; RESETn; x 8bit; PCIE2.0; USB HOST1; 40pin Connecting Base; USB2.0 OTG; USB3.0; TYPEC USB3.0; MIPI_CSI_RX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

ROCK 3 Zero W Ref Block Diagram

22PIN FPC 4 Lane MIPI CSI _RX

# RK3566_K(VCCIO4 Domain) RK3566_O(SARADC/OTP)

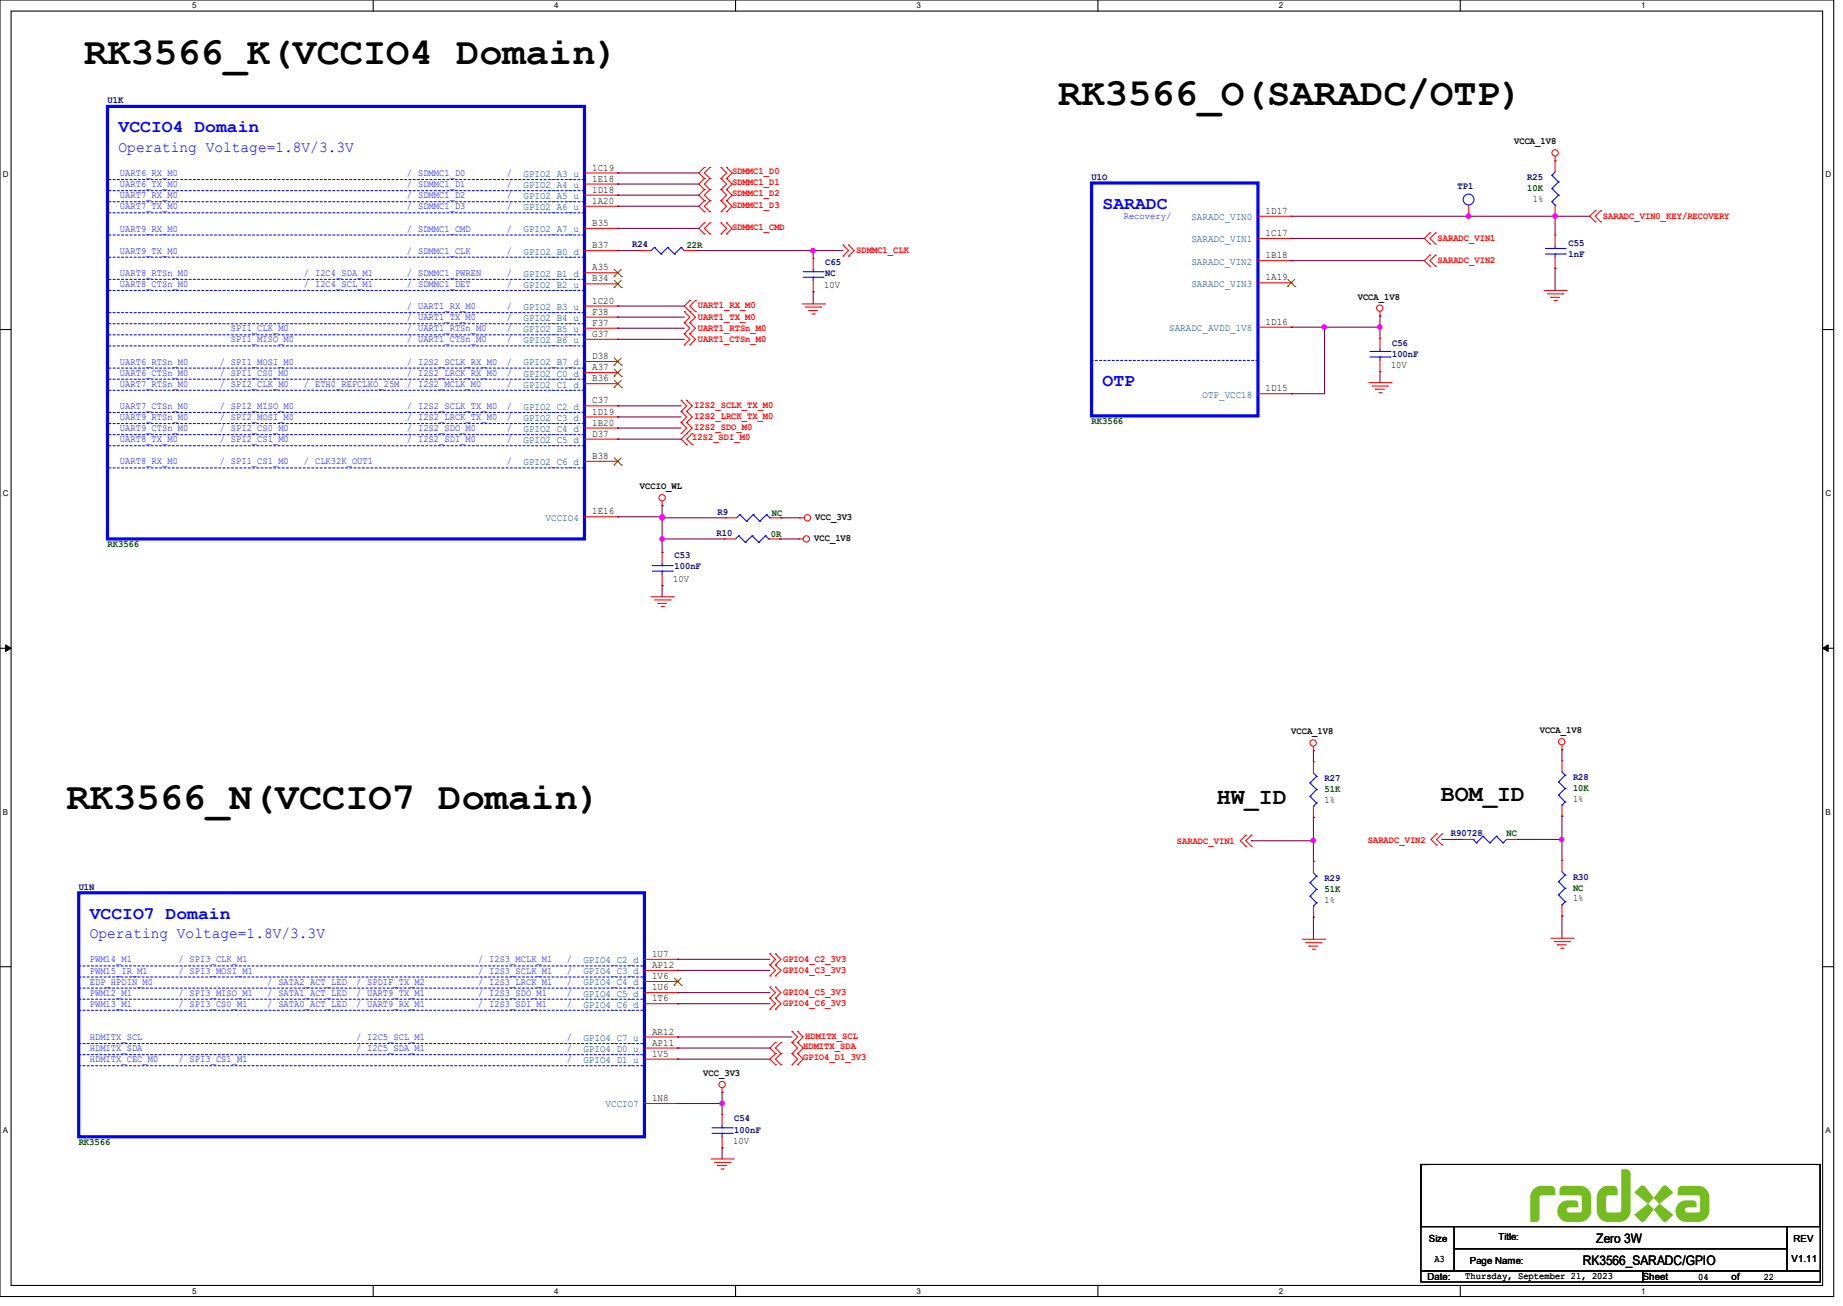
[picture p54: page 4]

RK3566_U | RK3566_V

## USB_OTG0_DP

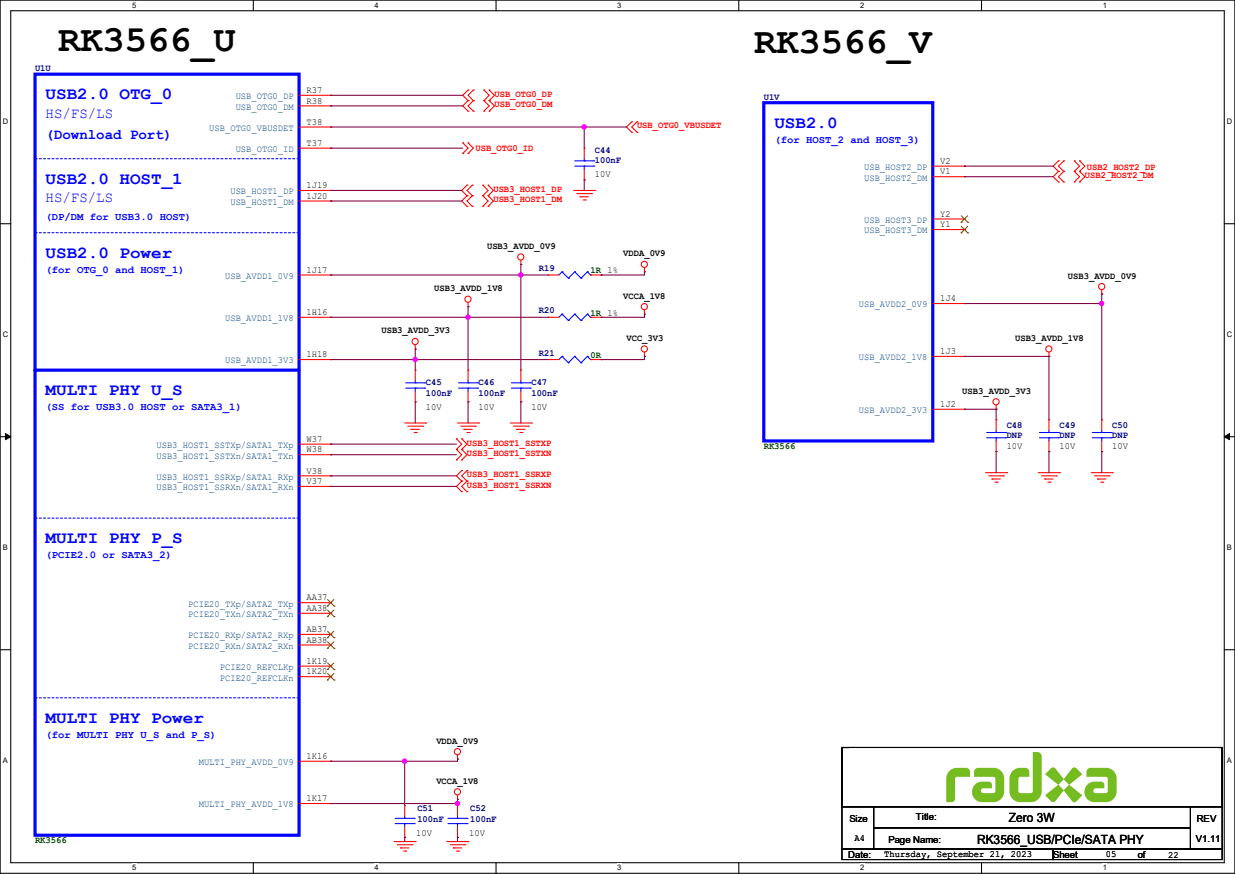
[picture p55: page 5]

USB2.0 HOST_1
(DP/DM for USB3.0 HOST)
USB2.0 Power
(for OTG_0 and HOST_1)

MULTI PHY U_S
(SS for USB3.0 HOST or SATA3_1)

MULTI PHY Power
(for MULTI PHY U_S and P_S)

# RK3566(OSC/PLL/PMUIO1/2)

OSC | PMUIO1 Domain

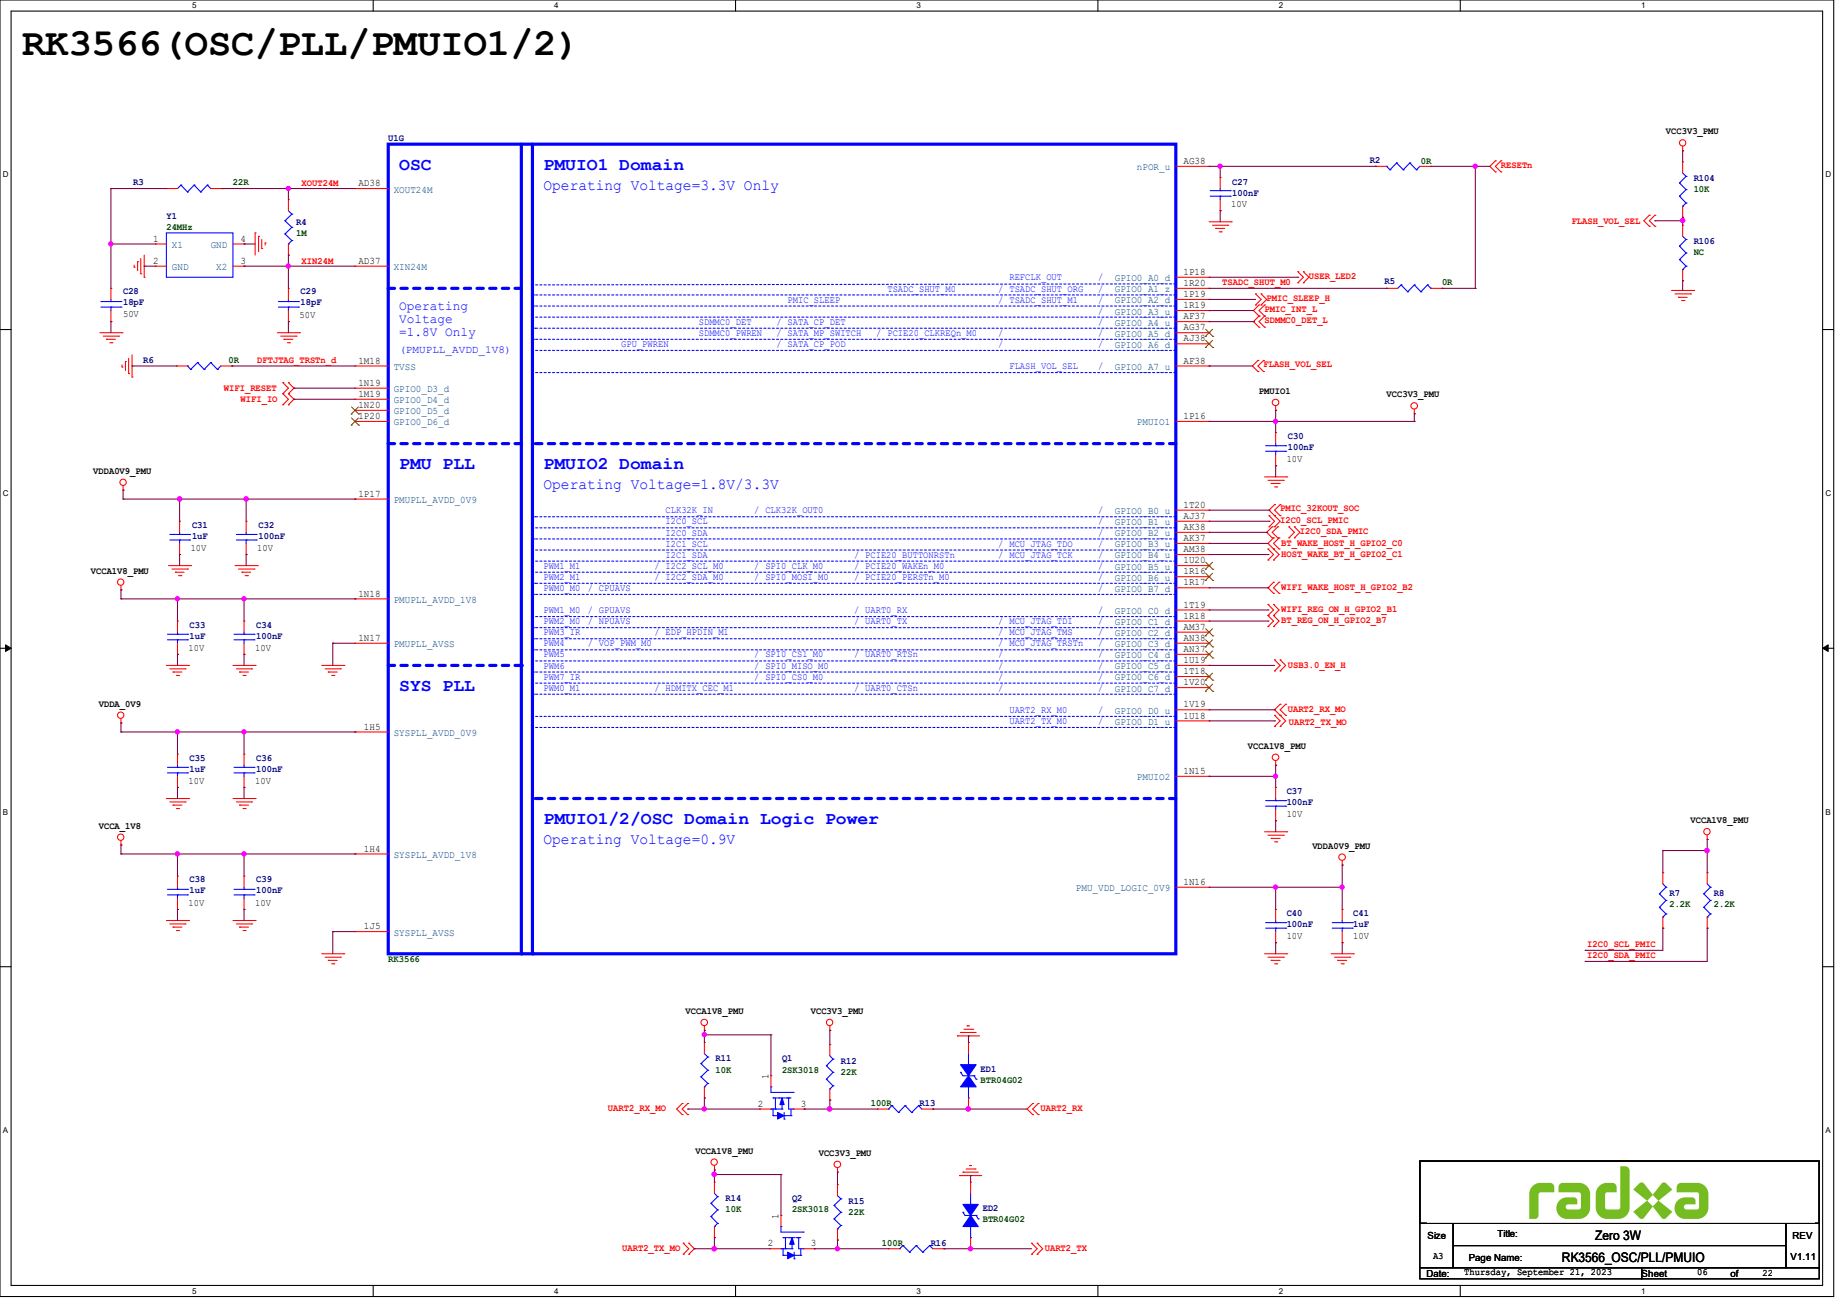
[picture p56: page 6]

PMUIO1/2/OSC Domain Logic Power
Operating Voltage=0.9V

# RK3566_ABCDE (Power&GND)

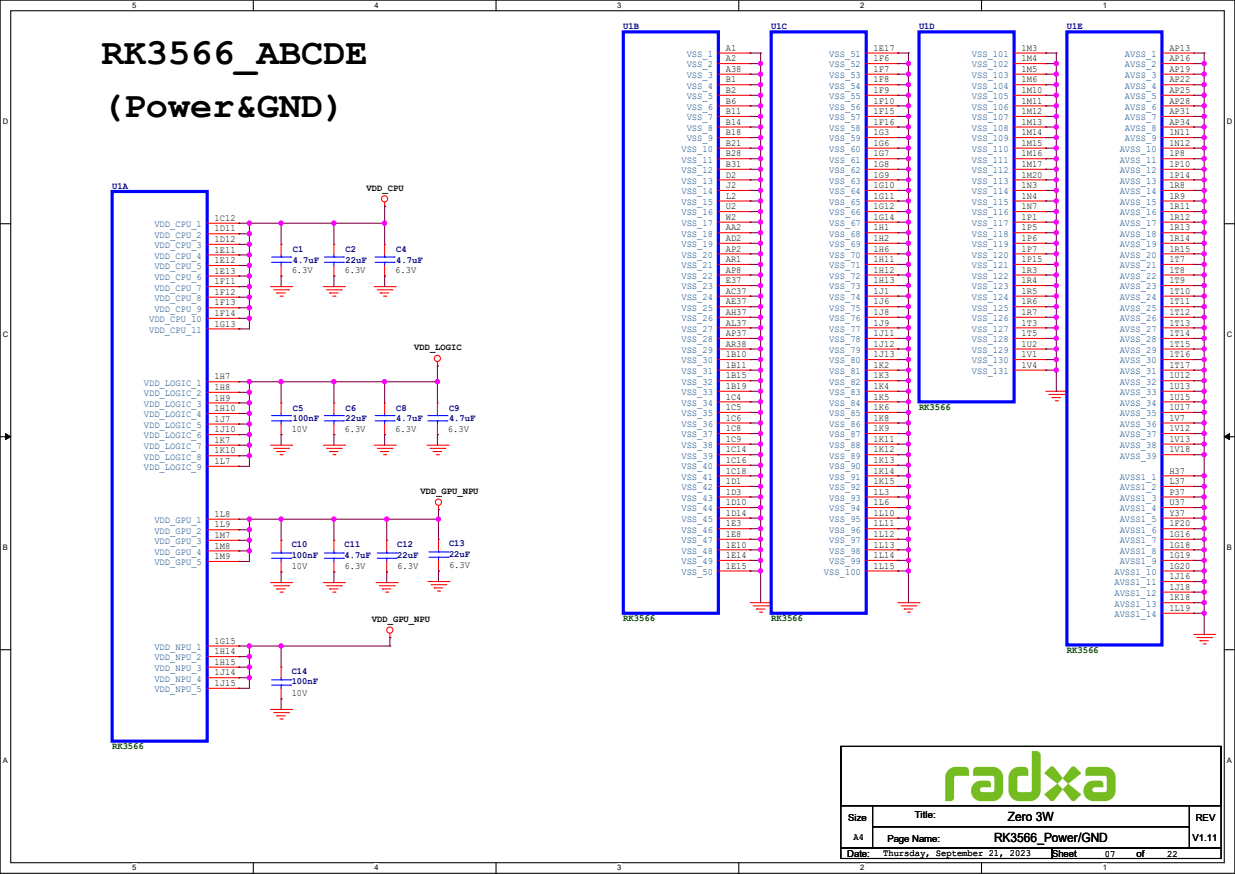
[picture p57: page 7]

# RK3566_F(DDR PHY)

## DDR4

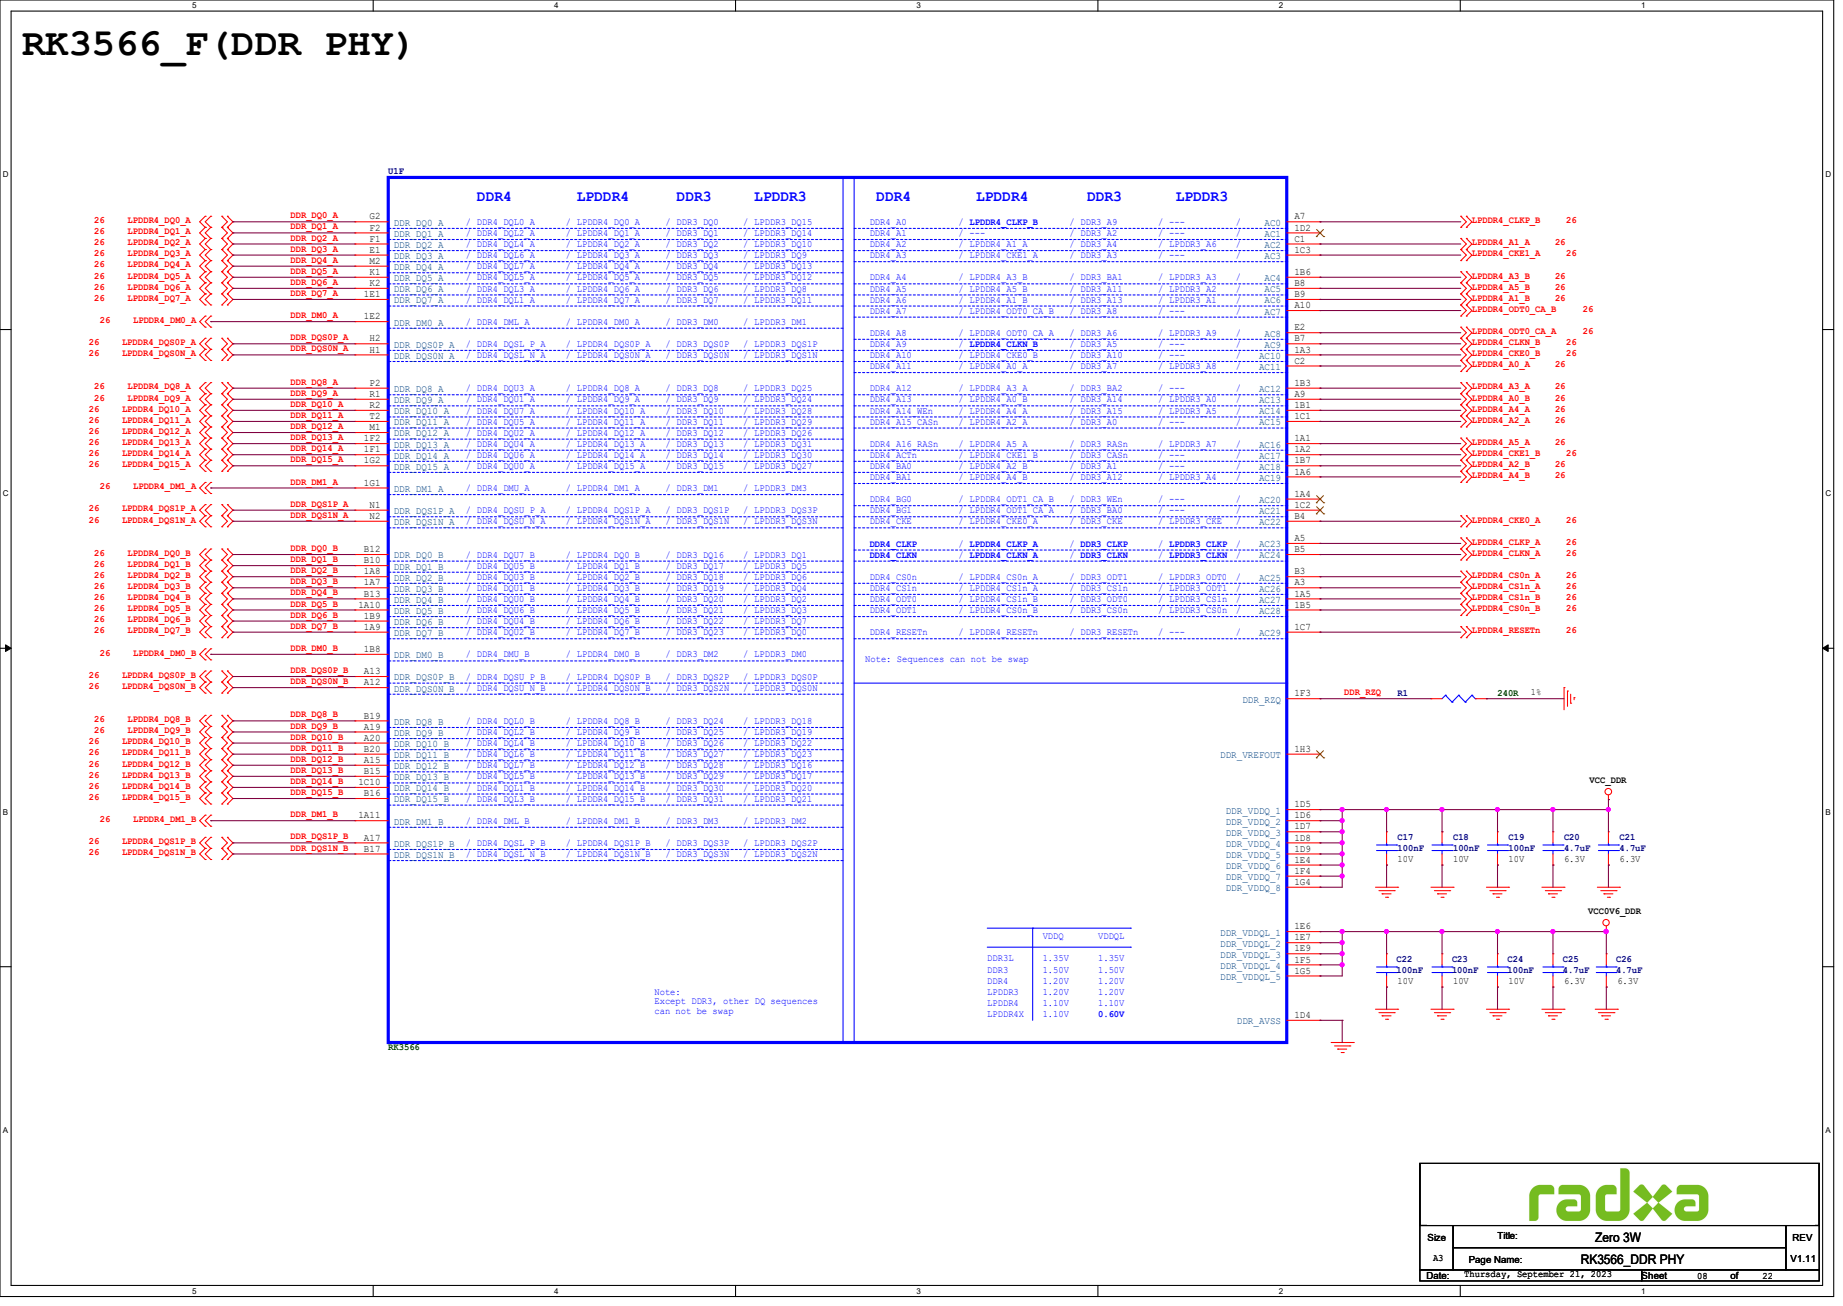
[picture p58: page 8]

Note: Sequences can not be swap

Note:
Except DDR3, other DQ sequences
can not be swap

# RK3566_P(MIPI_CSI_RX)

# MIPI_CSI_RX 4Lanes VDDA_0V9

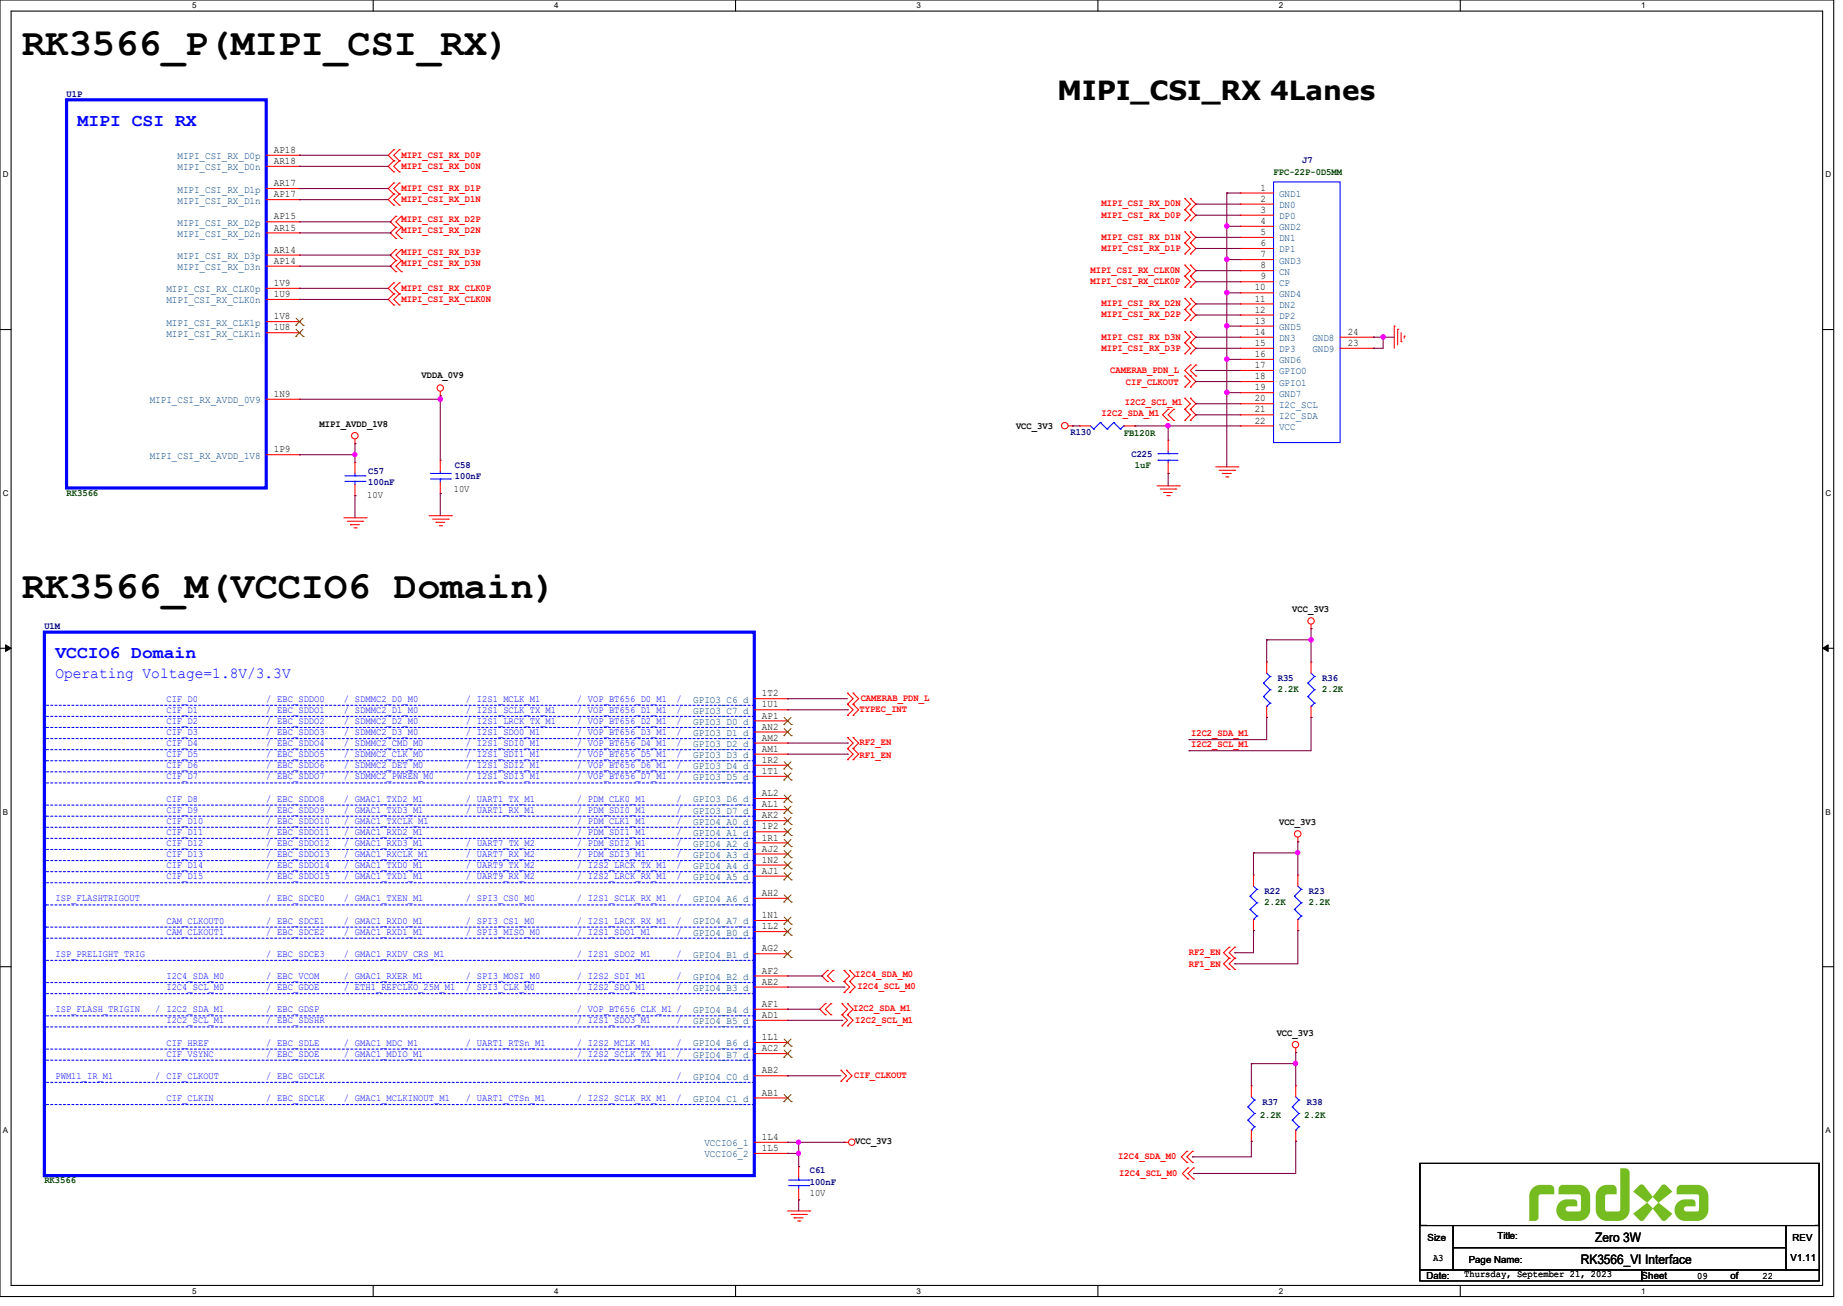
[picture p59: page 9]

RK3566_R(MIPI_DSI_TX0/LVDS_TX0) | RK3566_S(MIPI_DSI_TX1/LVDS_TX1)

# MIPI DSI TX1

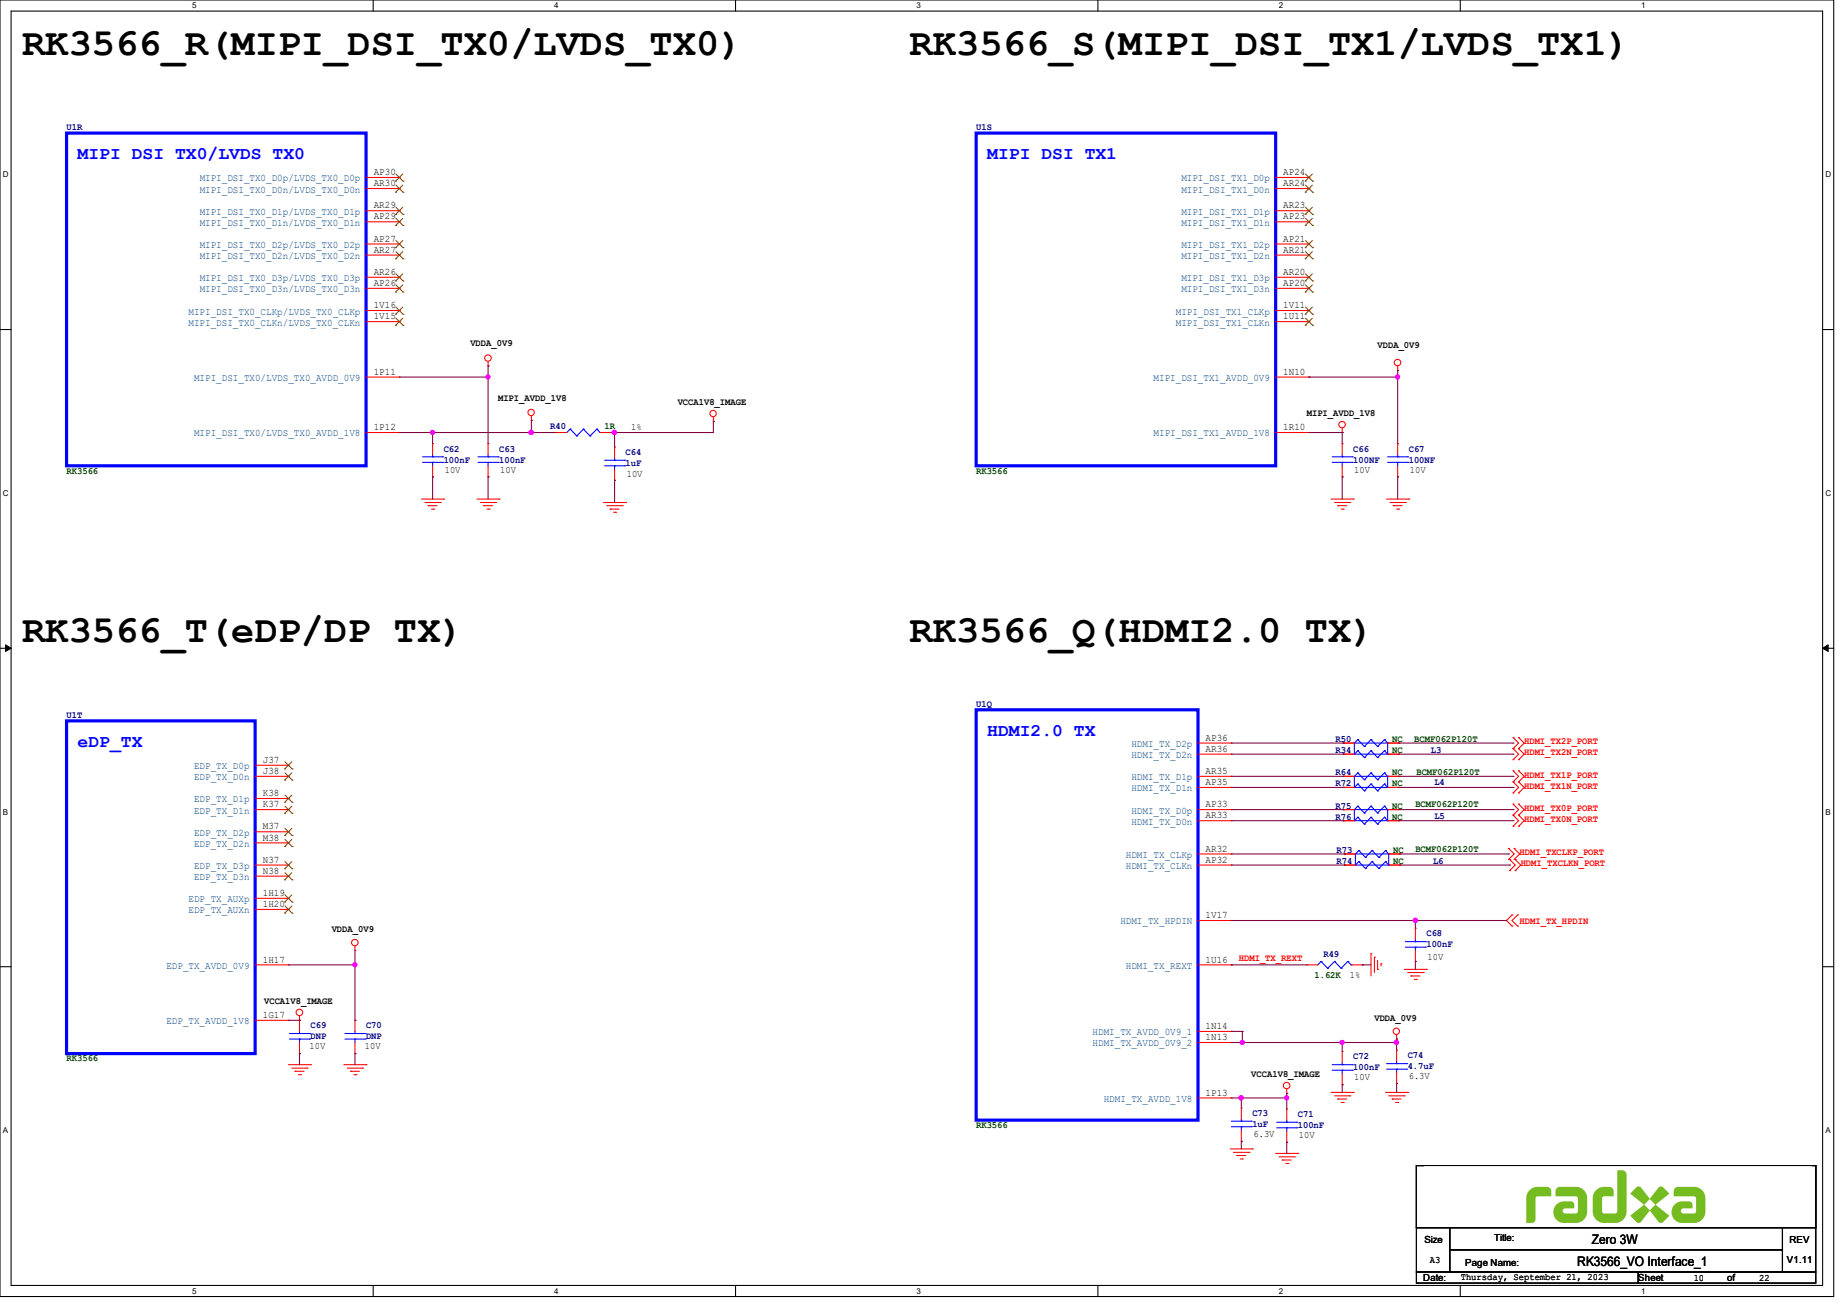
[picture p60: page 10]

# RK3566_L(VCCIO5 Domain)

# Operating Voltage=1.8V/3.3V

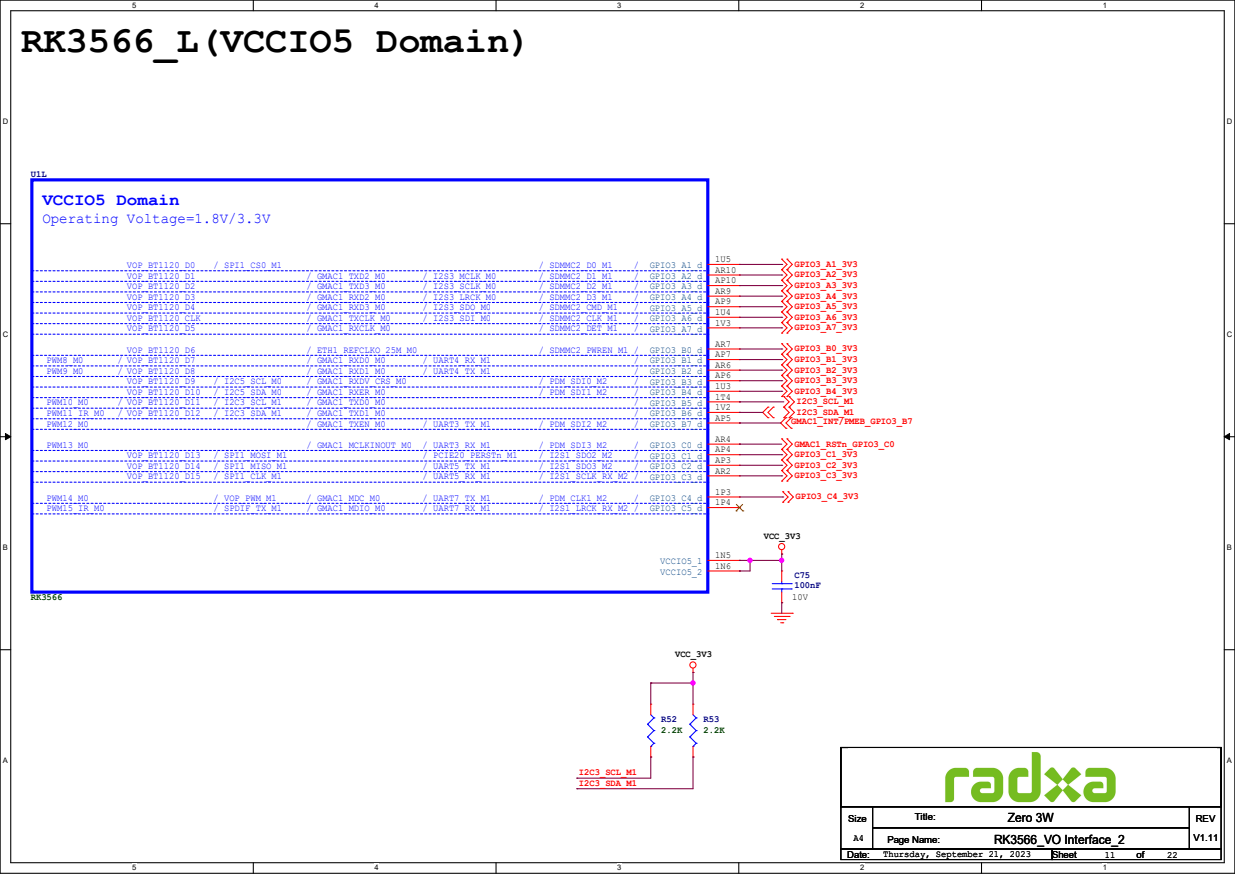
[picture p61: page 11]
VCC_3V3; GPIO3_A1_3V3 GPIO3_A2_3V3 GPIO3_A3_3V3 GPIO3_A4_3V3 GPIO3_A5_3V3 GPIO3_A6_3V3 GPIO3_A7_3V3; GPIO3_B0_3V3 GPIO3_B1_3V3 GPIO3_B2_3V3 GPIO3_B3_3V3 GPIO3_B4_3V3 I2C3_SCL_M1 I2C3_SDA_M1; GMAC1_RSTn_GPIO3_C0 GPIO3_C1_3V3 GPIO3_C2_3V3 GPIO3_C3_3V3; GPIO3_C4_3V3; GMAC1_INT/PMEB_GPIO3_B7; Page Name:; RK3566_VO Interface_2; Thursday, September 21, 2023; 22 Size; REV; VCCIO5 Domain; I2S3_SDO_M0; UART4_TX_M1; PDM_SDI3_M2; GMAC1_TXCLK_M0; UART5_RX_M1; SDMMC2_CMD_M1; GMAC1_RXD2_M0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

# RK3566_H(VCCIO1 Domain)

## GPIO1_A0_3V3

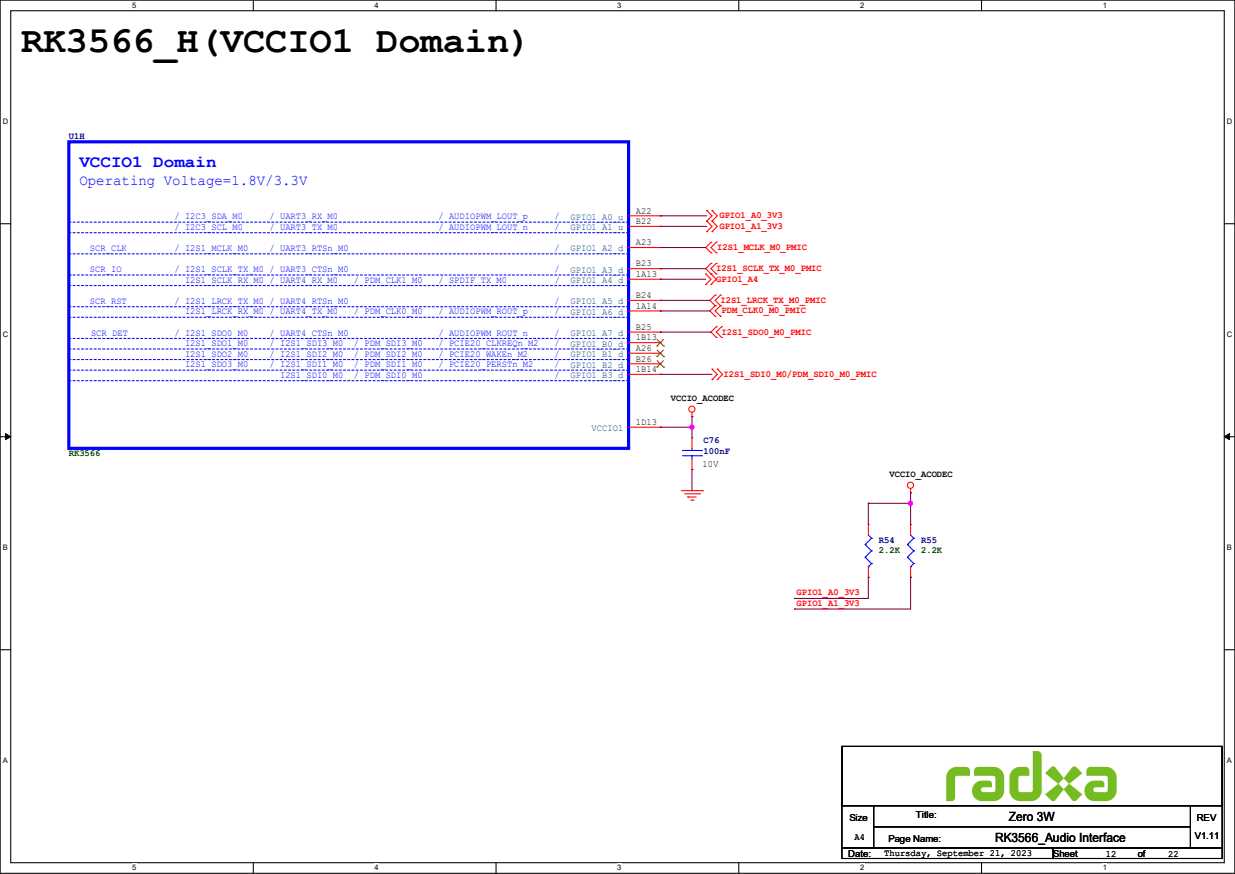
[picture p62: page 12]
VCCIO_ACODEC; GPIO1_A1_3V3; GPIO1_A4; I2S1_MCLK_M0_PMIC; I2S1_SDI0_M0/PDM_SDI0_M0_PMIC; I2S1_SCLK_TX_M0_PMIC; I2S1_LRCK_TX_M0_PMIC PDM_CLK0_M0_PMIC; I2S1_SDO0_M0_PMIC; Page Name:; RK3566_Audio Interface; Thursday, September 21, 2023; 22 Size; REV; VCCIO1 Domain Operating Voltage=1.8V/3.3V; UART4_CTSn_M0; SPDIF_TX_M0; I2C3_SDA_M0; PCIE20_WAKEn_M2; UART3_RTSn_M0; PDM_CLK0_M0; UART4_RX_M0; I2S1_LRCK_TX_M0; I2S1_SDI1_M0; I2S1_SDO3_M0; UART3_CTSn_M0; PDM_CLK1_M0; PDM_SDI1_M0; I2S1_SDO1_M0; SCR_CLK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

# RK3566_I(VCCIO2 Domain)

## eMMC_D0/FLASH_D0

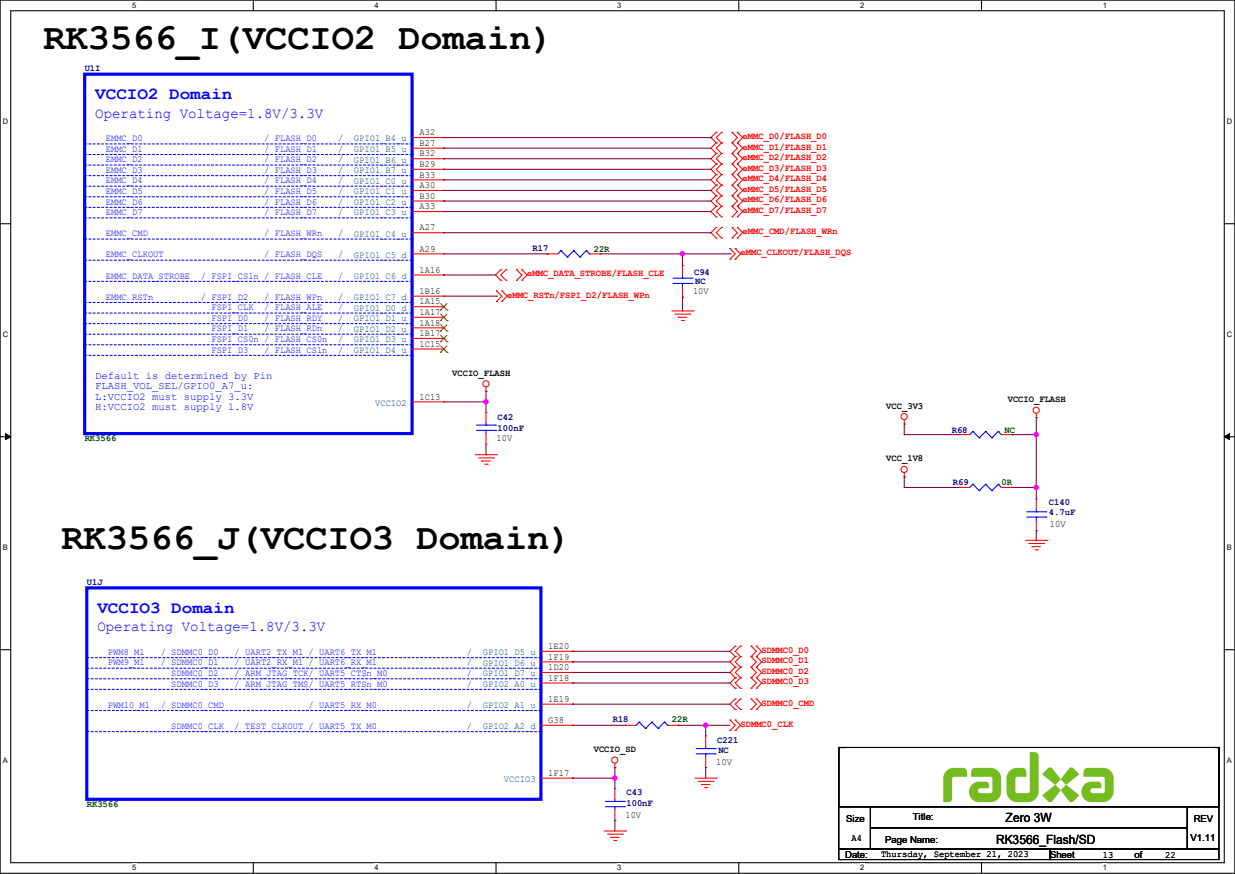
[picture p63: page 13]

Default is determined by Pin
FLASH_VOL_SEL/GPIO0_A7_u:
L:VCCIO2 must supply 3.3V
H:VCCIO2 must supply 1.8V

# CH A CH B

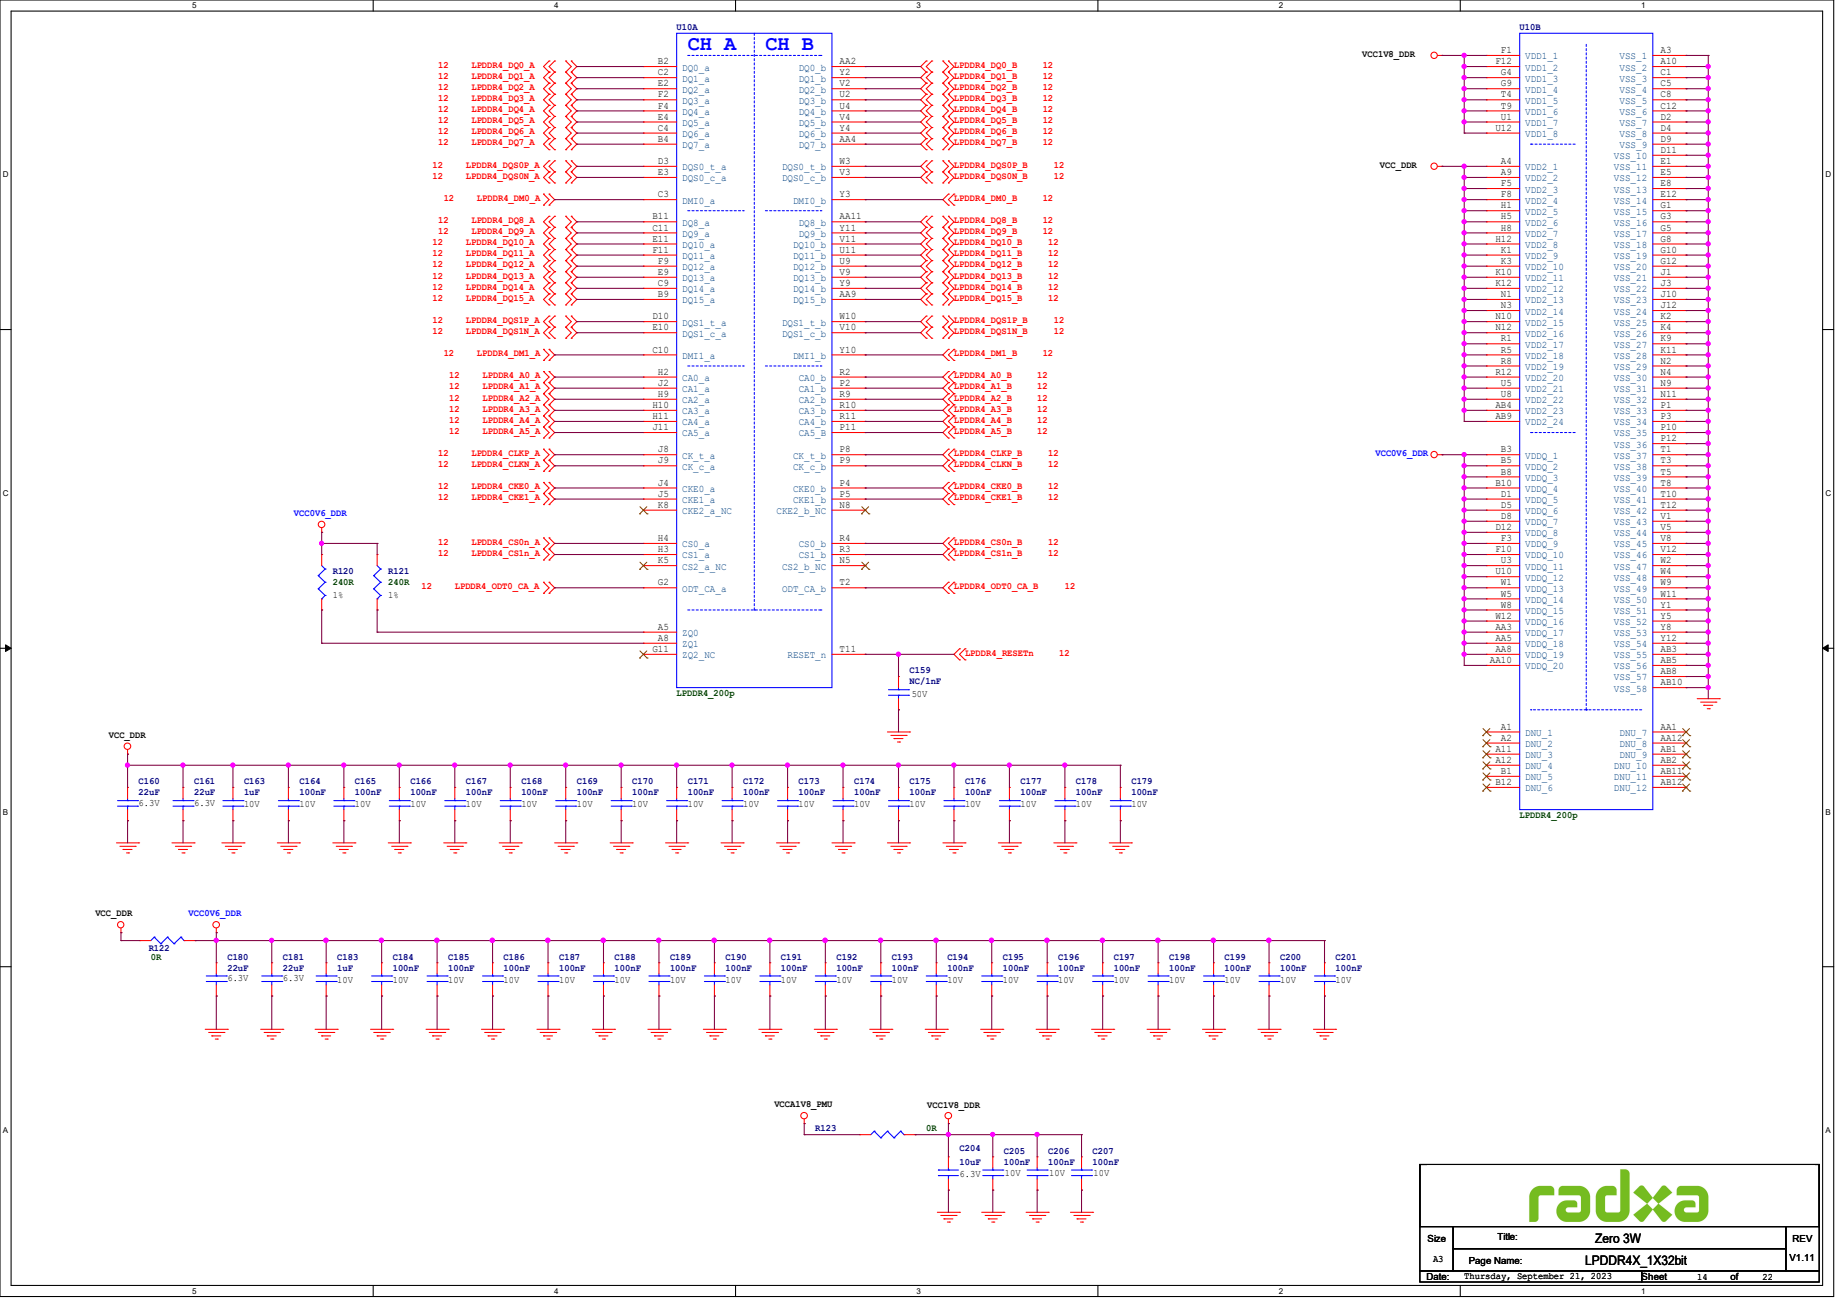
[picture p64: page 14]

# EMMC FLASH

## VCC_3V3

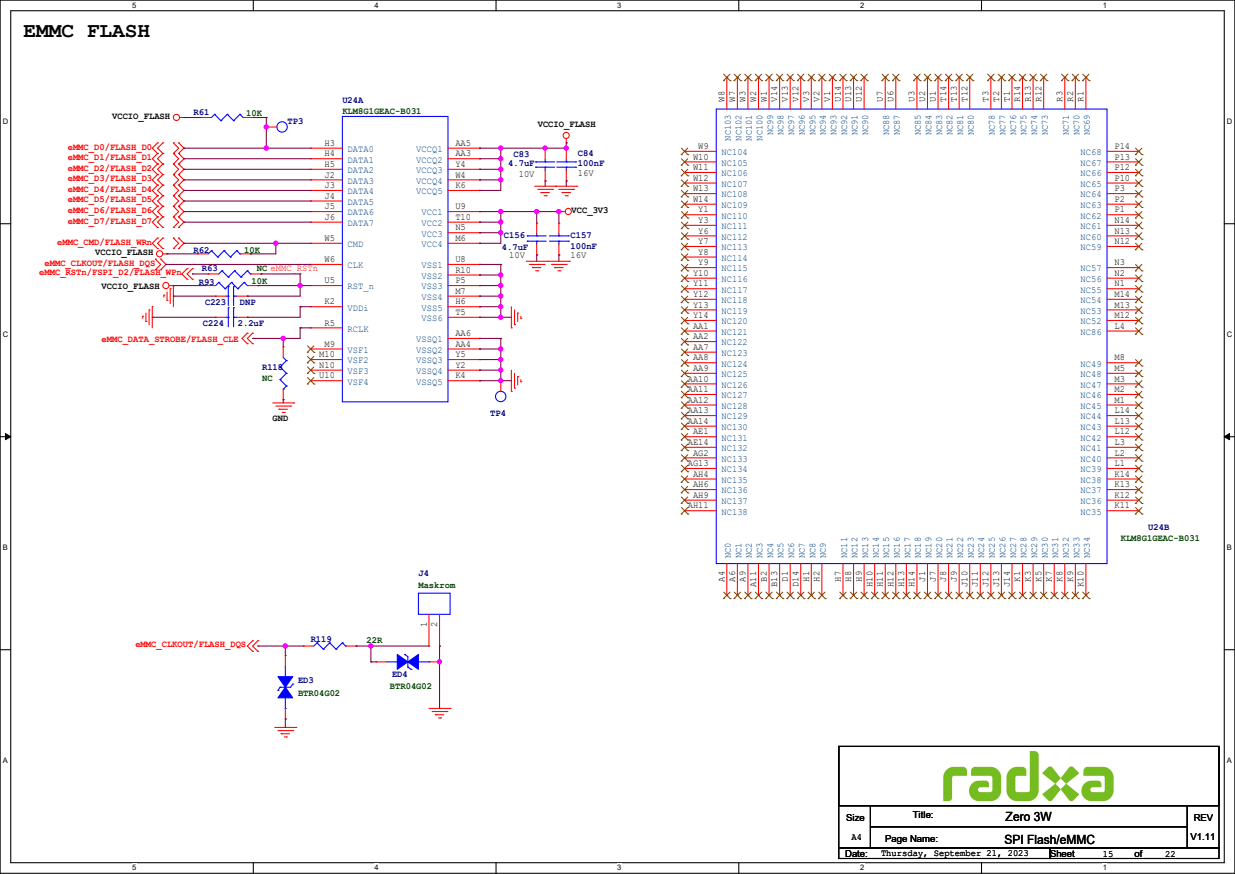
[picture p65: page 15]

# MicroSD Card

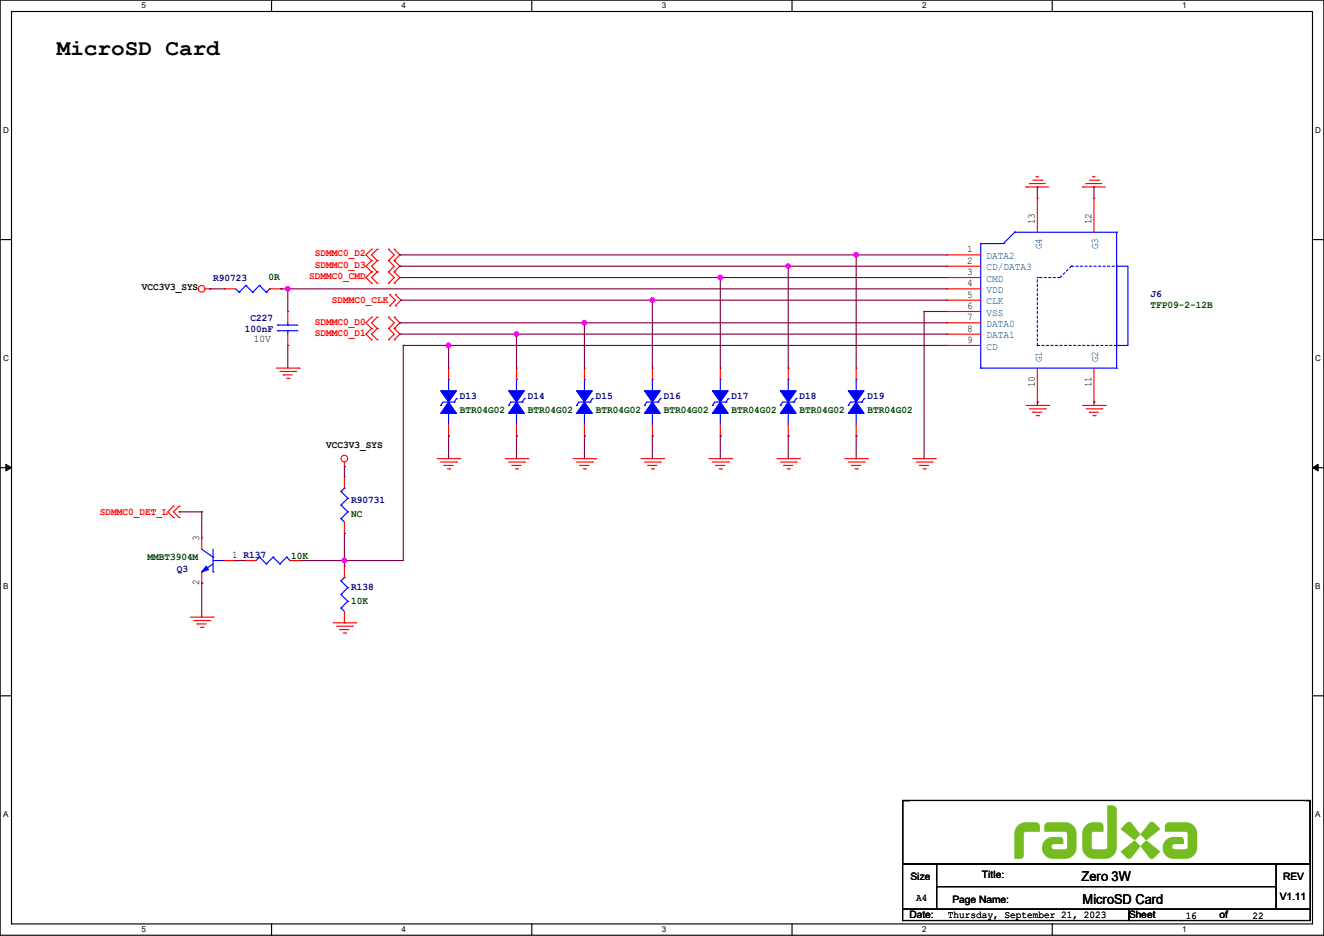
[picture p66: page 16]

CD/DATA3 2

## AO_5V_B

VCC_3V3 | VCC_3V3

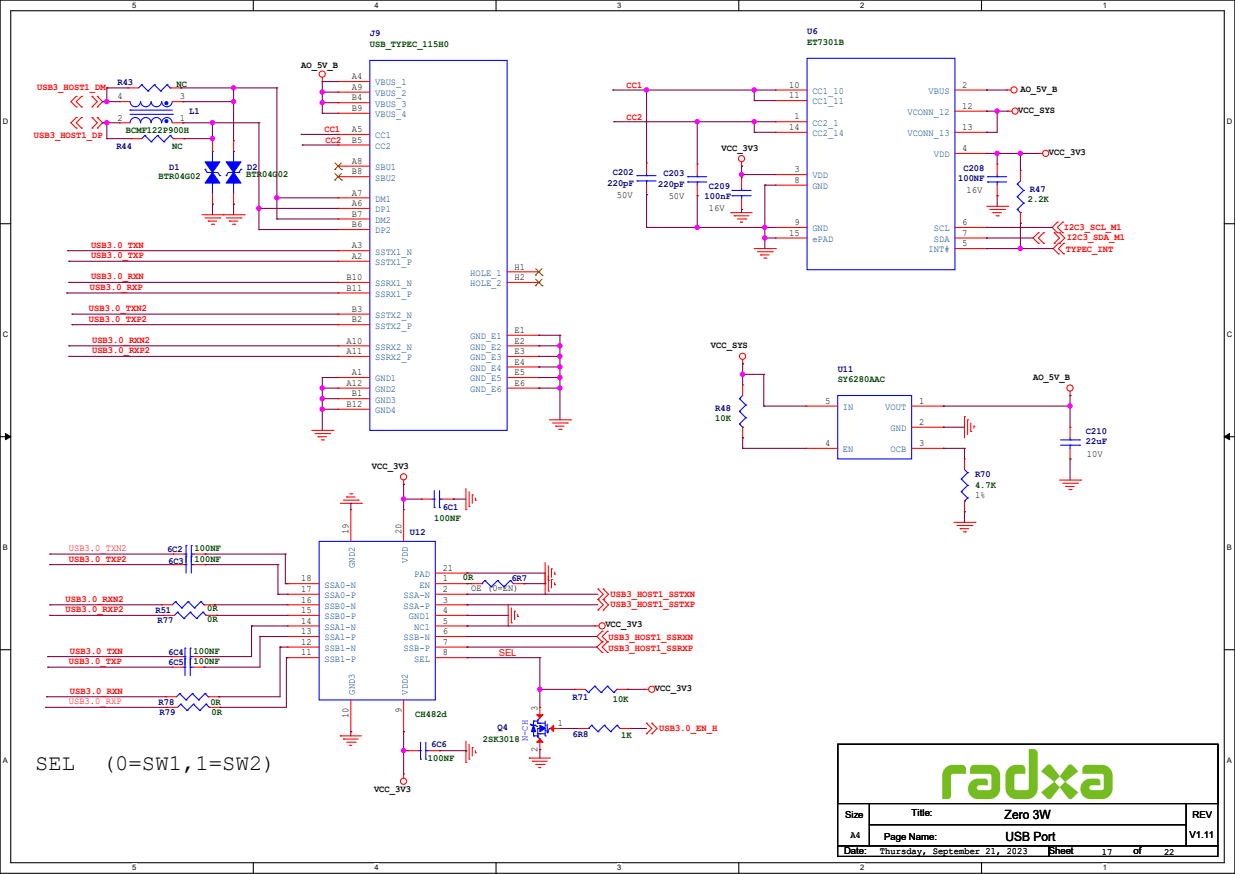
[picture p67: page 17]

VCC5V0_HDMI | VCC_3V3

## VCC_3V3

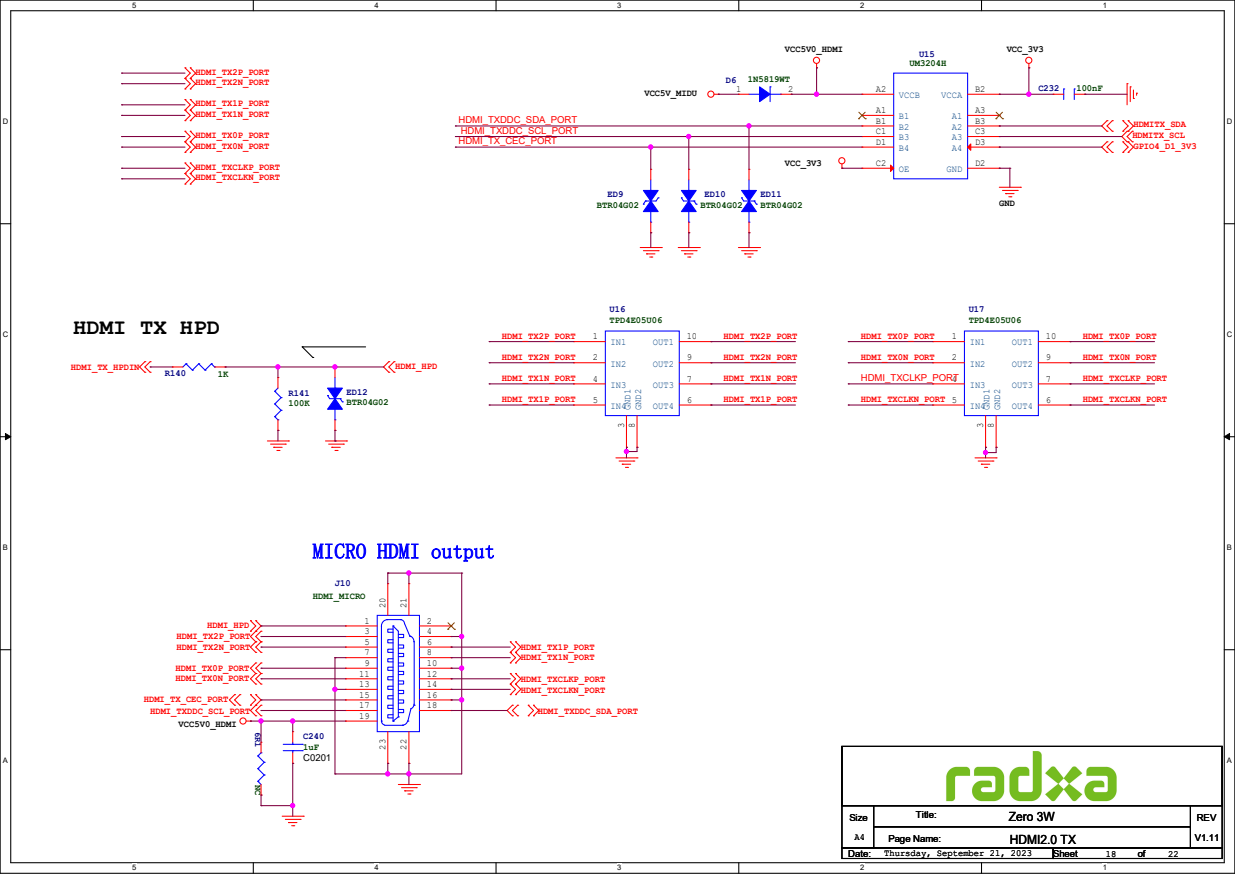
[picture p68: page 18]

SDIO WIFI/BT | RF Microstrip Z0= 50 ohm

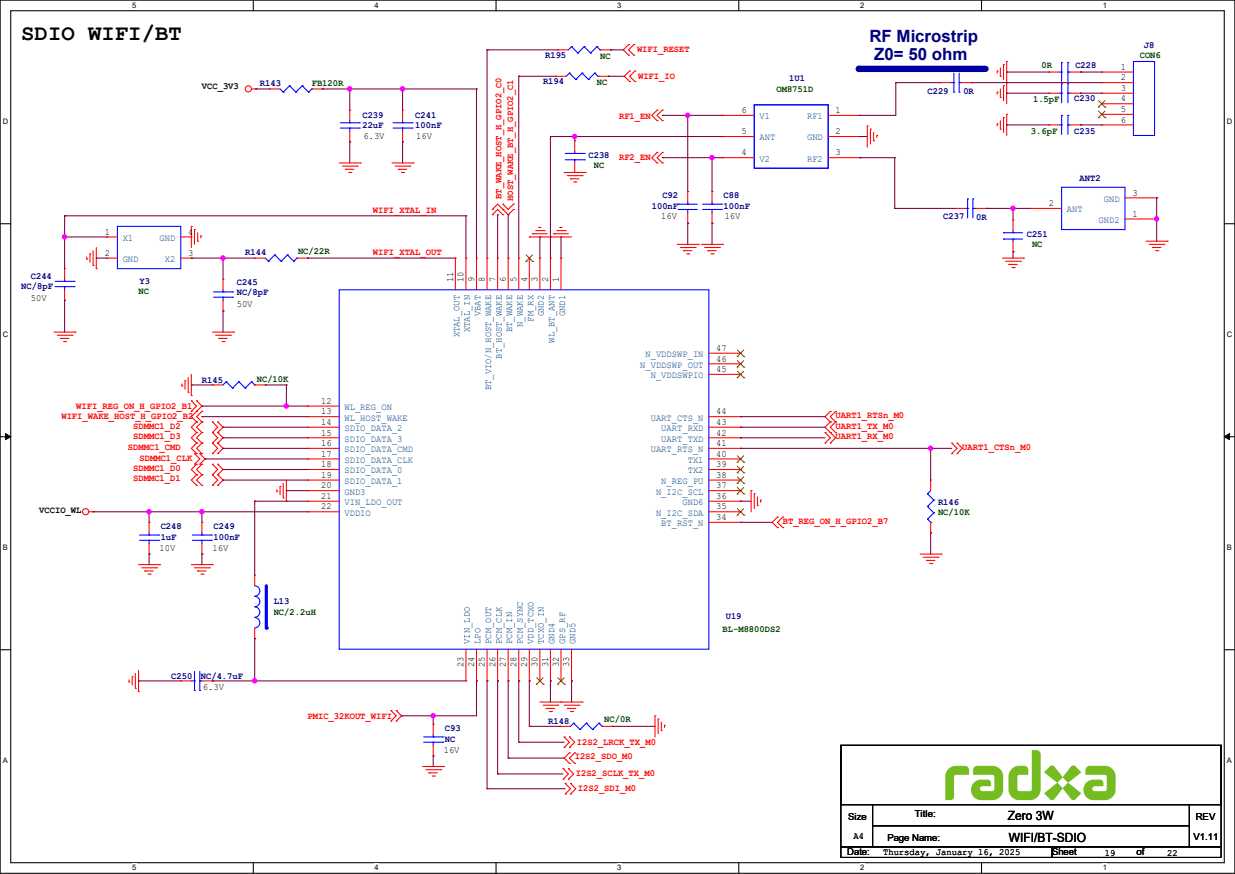
[picture p69: page 19]

VCC3V3_SYS | +5V_INPUT

## VCC3V3_SYS

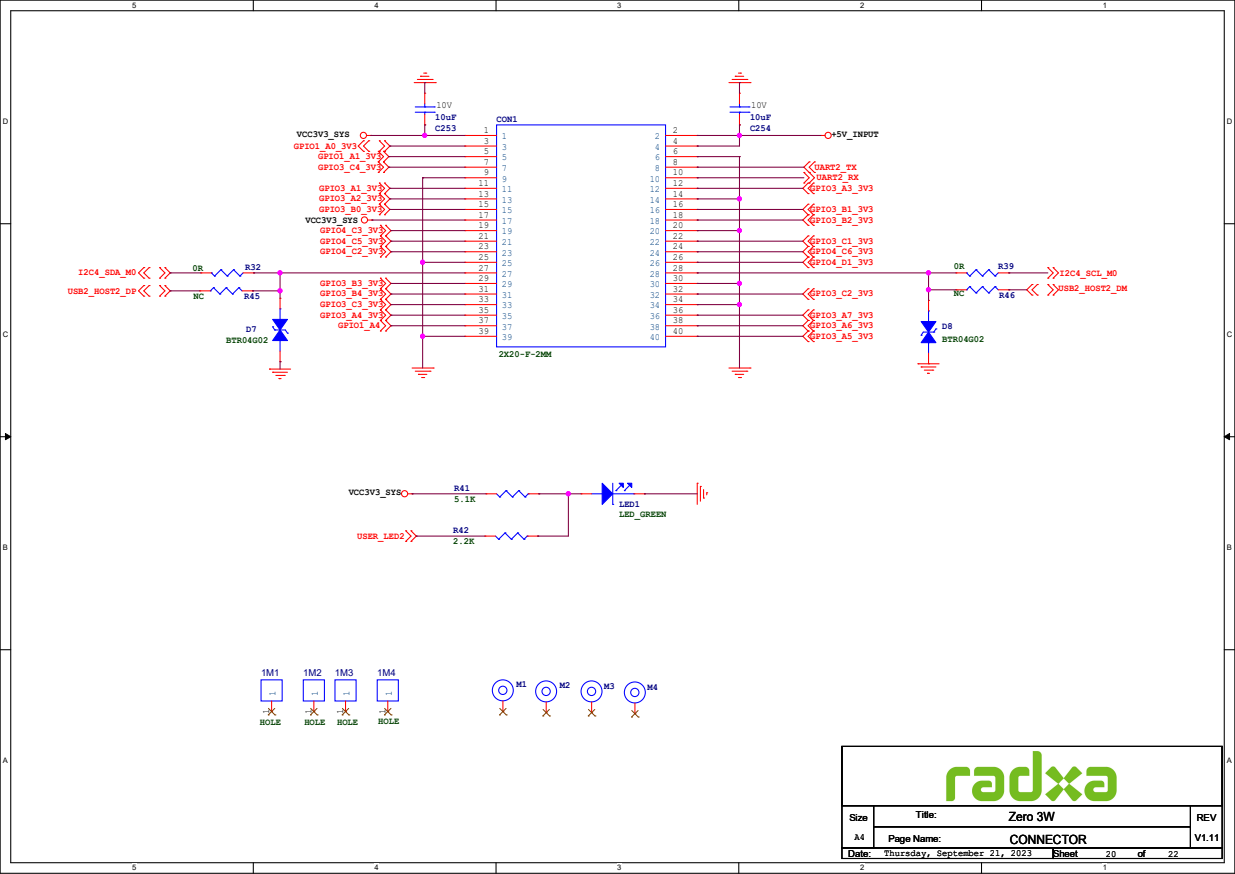
[picture p70: page 20]

PMIC RK817 DCDC | PMIC RK817 LDO

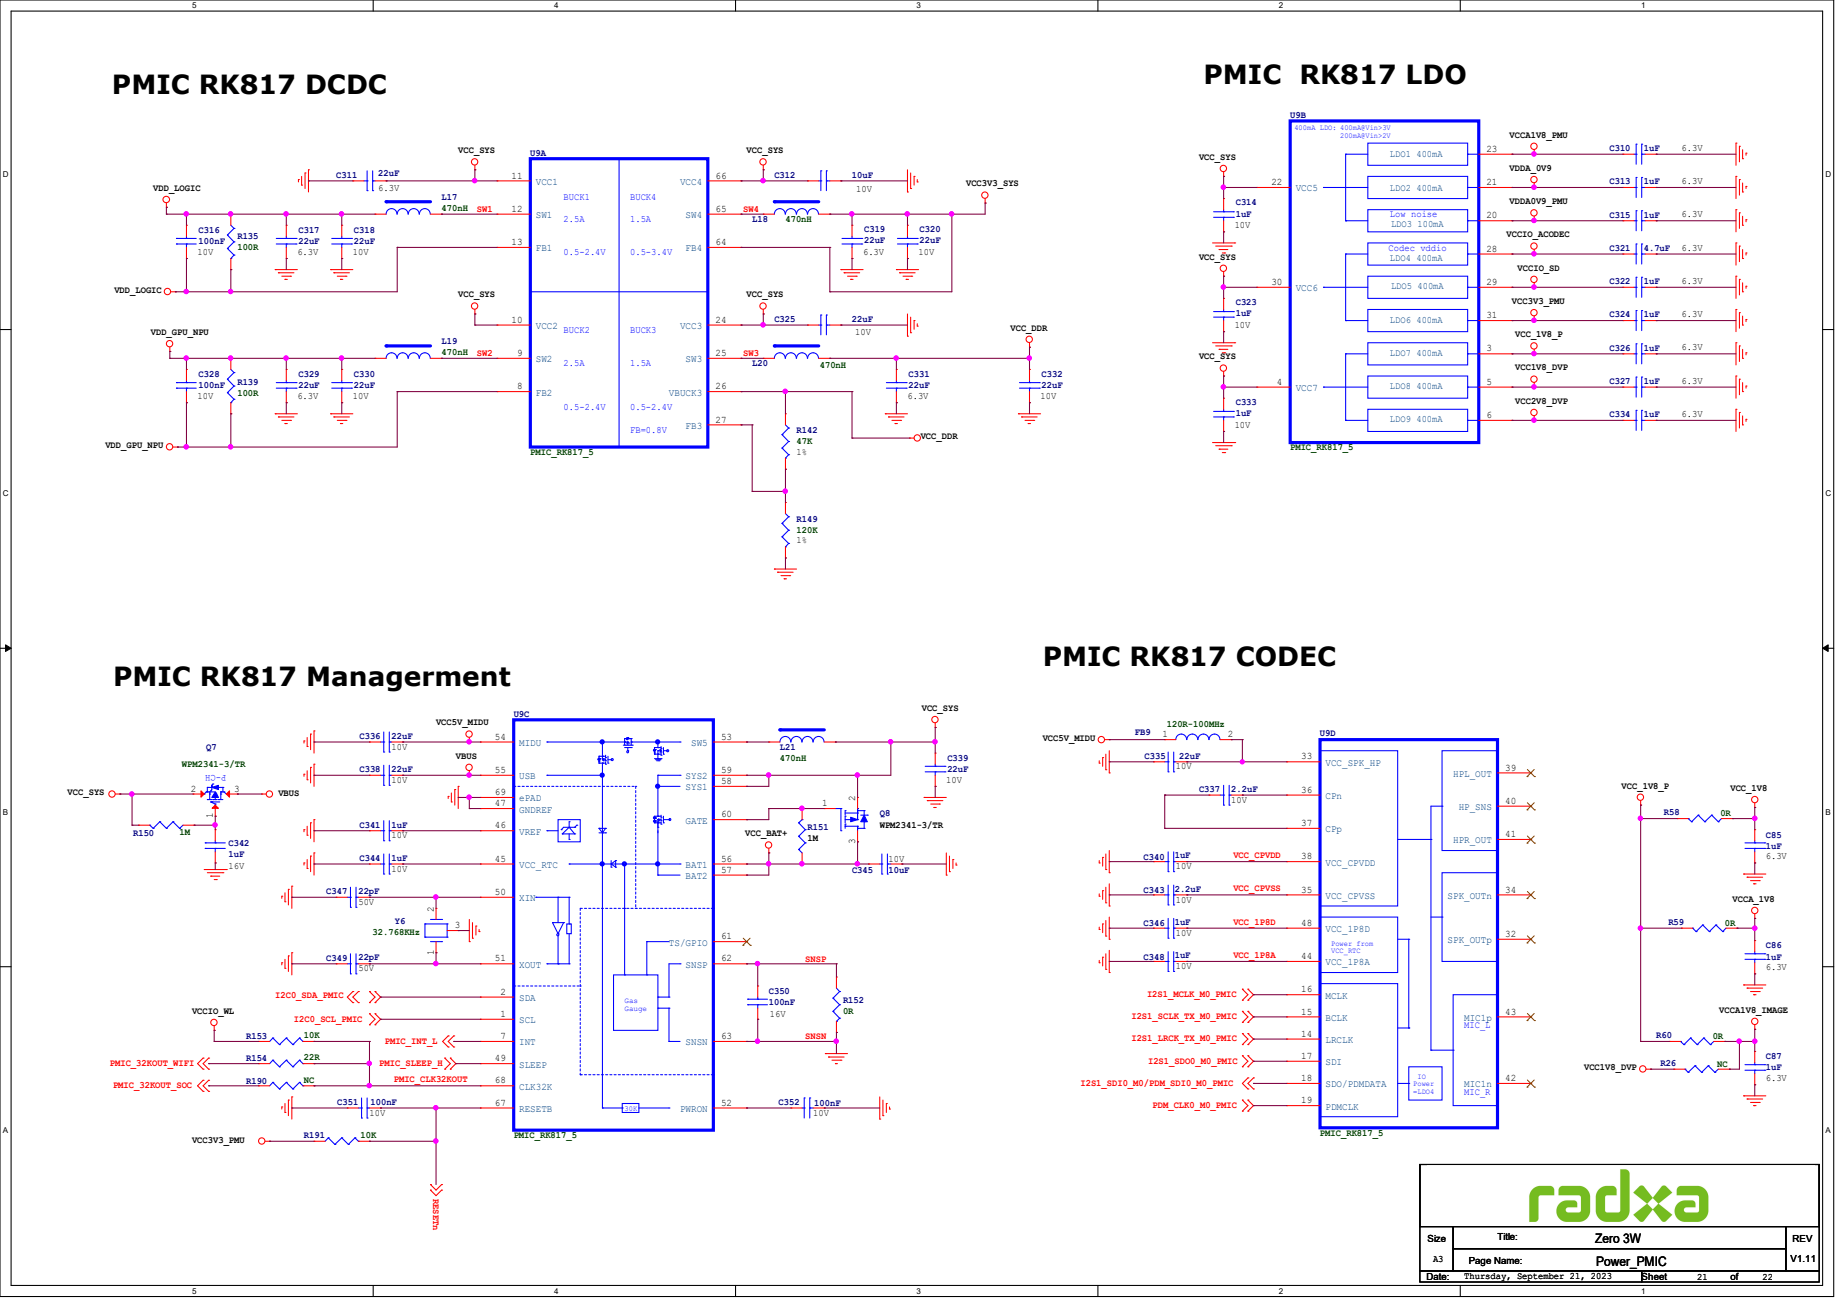
[picture p71: page 21]

DC 5V IN | VCC_3V3 (Power OFF under SLEEP)

## VCC_SYS

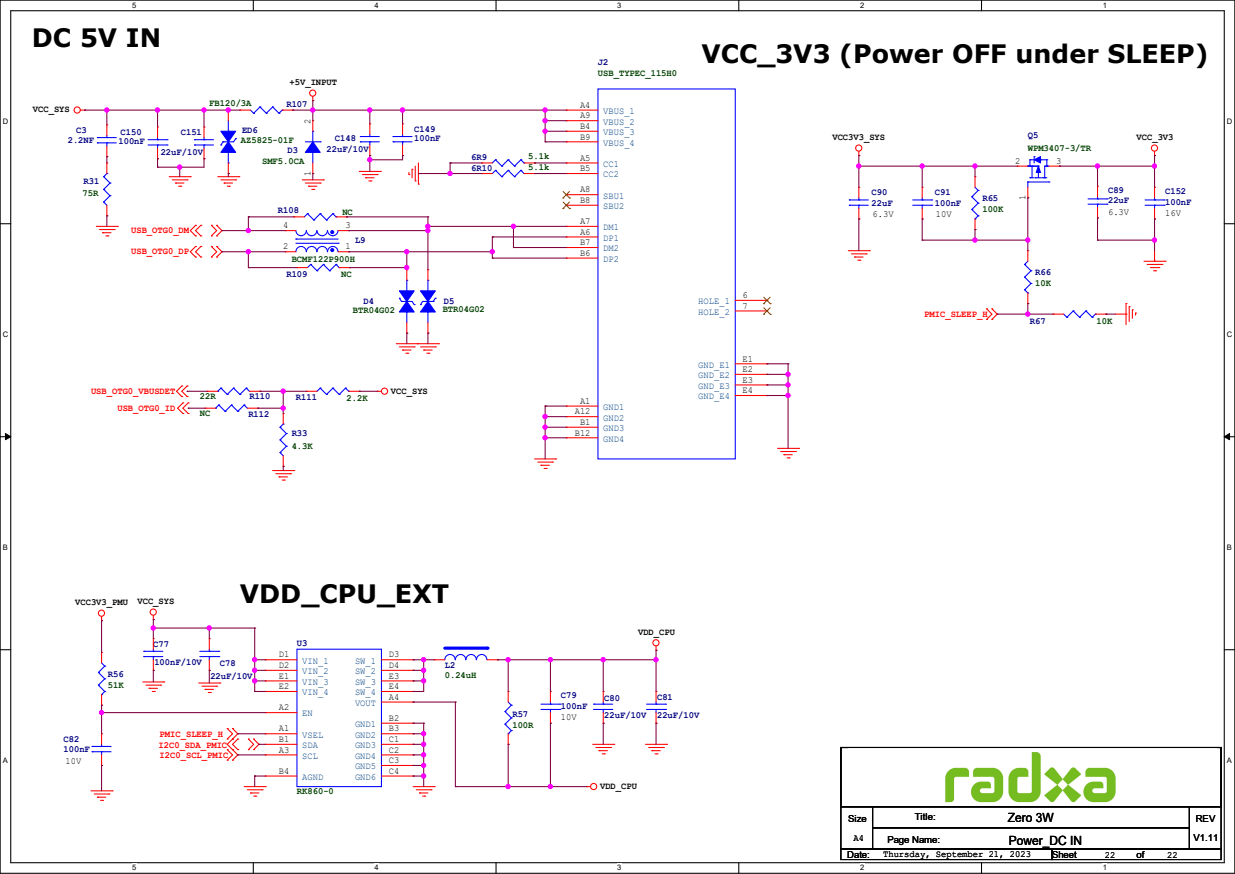
[picture p72: page 22]
