shenjin73/microduck-build/(commit log)

2026-09-15 路线图与决策日志：用第三方舵机复刻 microduck
2026-09-16 添加 microduck-lab submodule 与验证/风险计划文档
    - 引入 microduck-lab 作为子模块
    - 新增 custom-motor-guide.md 与 microduck-clone-validation-risk-plan.md
2026-09-16 风险计划：新增 Week 0.5 Apple Silicon 吞吐前置验证 (采购硬件前的 Go/No-Go)
    - 把'Apple Silicon 能否替代 NVIDIA 正式训练'从 Week 8-9 前置为独立里程碑
    - 区分功能正确性(软件)与吞吐可行性(决定成败)两件事
    - 加入决策表(Mac vs 云 GPU 的 steps/sec、单次训练耗时/成本)与 Go/No-Go 判定
    - Week 8-9 与结论摘要改为引用 Week 0.5 结论，避免重复纠结
2026-09-16 Week 0.5 吞吐基准实测：Mac 上 microduck_rl 不可行，microduck_local 可过夜
    用官方 microduck_rl 的 MicroDuck velocity 任务在 M5 Max (18 核, 128 GB) 上实测，
    回答风险计划 Week 0.5 的 Go/No-Go，全部数据可复现（脚本 + 原始日志随报告提交）。
    关键发现：
    - 官方命令在 Apple Silicon 上开箱即死：select_gpus() 索引空 CUDA 列表
    (mjlab/utils/gpu.py:70)，早于 iteration 0。
    - 但 mjlab 自带 CPU 模式 (gpu.py:56)，CUDA_VISIBLE_DEVICES="" 即可真跑，
    无需改源码；wandb 未配 key 需 WANDB_MODE=disabled。
    - 吞吐阶梯 64→4096 envs：1024 envs 触顶 953 steps/s，再堆 env 反而降到 825。
    内存从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
2026-09-16 附录 A：记录 Week 0.5 基准报告的四轮修正及其证据
    修正记录散落在各节里，后续读者看不出哪些结论被推翻过、凭什么推翻。
    新增附录 A（A.1 被修正的论断 / A.2 经复核无误的数字 / A.3 仍未证的命题 /
    A.4 一类反复出现的错误），每条附可复核的 file:line 证据。
    被修正的 7 条：
    - 作者口头声称「local 与 rl 不能互相替代」——过度声称，收回（README 是对风险的
    建议而非能力判定，且 custom-motor-guide.md §6 主张相反做法）
    - 「DR 是子集」由模糊精确为 3 个 obs 级项（IMU 安装误差/编码器 bias/IMU 延迟）
    - 「backlash 是 rl 独有、local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
2026-09-16 Week 0.5 结案：把 Apple Silicon 吞吐实测结果写回风险计划
    按项目惯例（microduck_local/AGENTS.md: "write the answer back into the item
    when you finish one"），把 Week 0.5 的结论写回计划本身，使计划自洽。
    - Week 0.5 标题标记 ✅ 已完成 2026-09-16，正文顶部加结果块：
    三条结论（rl on Mac No-Go 4.8–60 天；local on Mac ~19,000 steps/s 过夜可行；
    MPS/Apple GPU 无用，上限 1.41%）+ 对后续阶段的影响。
    - 交付物一行改为 ✅ 已交付，指向 benchmark 报告及其附录 A。
    - 结论摘要第 3 条：把「应在采购硬件前用数字定论」替换为已定论的结论。
    - Week 8–9 前提：路线选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
2026-09-16 全文吞吐口径统一：每个吞吐数字都标明 harness，并修正一处实质错误
    问题：报告第 0 节开头只写「吞吐只有约 950 env steps/sec」，未提同机
    microduck_local 的 ~19,000，读者会以为这台 Mac 只有这个水平。全文过一遍后
    发现 6 处只写单边，另有 1 处是实质性错误。
    修正：
    - 第 0 节：开篇即给出两个 harness 的数字，单次训练表由 2 行扩为 3 行
    (rl / local / 云 GPU)，红线补一条「必须注明用的是哪个 harness」，
    建议路线改为 A 云 GPU + B Mac 过夜两条路并列表。
    - 第 1 节：测试环境表新增两 harness 对照（物理后端/并行方式/训练栈/本机吞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
2026-09-16 新增 9.6 节：为什么 microduck_local 只用 ~5 核（机器有 18 核）
    读者几乎一定会问的问题：18 核（6P+12E）却只用 ~5 核。实测答案是
    「~5 核是这个 harness 的并行效率上限，不是这台 Mac 的上限」，四条证据：
    - 瞬时核数平稳在 ~5（峰值 5.99 / p50 5.00），不是阶段交替的平均效应。
    用累计 CPU 时间差分测（cpu_phases.py）——ps -o %cpu 在 macOS 上是衰减
    平均，会抹掉阶段性，不能用。
    - 按进程采样：1 个父进程 105-144%（1.1-1.4 核），32 个 worker 每个仅 9-14%
    （~0.1 核）。worker 在等 IPC 往返，不是在算。
    - envs 32/64/96 对照：worker ×3 只换 +4%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
2026-09-16 修正 n_steps 误推 + 新增 envs 说明与附录 A.5（框架错）
    (1) 修正一处事实错误（A.1 #8）：本报告曾称 train-walk 的 n_steps ≈ 51，
    由日志里的 n_updates=1220 反推而来。真值是 n_steps = 256。
    1220 是「每 rollout 记 5 次」的计数器（对应 n_epochs=5），不是 rollout 次数；
    1M 步在 16 envs 下实为 244 次 rollout。
    权威依据：ppo_hparams.N_STEPS = 256，以及从 model.zip 读出的
    num_timesteps = 102,400（对 --steps 100_000）。吞吐 19,000 steps/s 不受影响。
    连带修正 4 处引用，并补上每次 rollout 的 batch 对比（8,192 vs 98,304，差 12 倍）
    —— 这是「step 数不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
2026-09-16 按风险计划第 8 节修正 custom-motor-guide.md（12 条，全部实测验证）
    初版有 8 处会直接误导操作的问题，逐条回源码/实测修正；验证时又新发现 4 条。
    每条都在当前 checkout 上实际跑过（argparse --help、_resolve_json_path、import 测试），
    不是从描述推断。
    计划第 8 节的 8 条：
    1. 「外形尺寸一致 → MJCF 无需修改」→ 改为「可先不改碰撞几何，但必须复核
    质量/惯量/CoM/限位/齿隙」，并给出判断阈值（总质量差 >5%、CoM 差 >5-10mm）。
    2. XL330 参考 3.7-6.0V / 0.43 Nm → repo 实际 vin=7.5V、DR 6.5-8.2V、限流 1.75A、
    kt×1.75A ≈ 0.6405 Nm。
    3. 暗示 BAM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
2026-09-16 新增硬件待确认清单：把计划第 7 节的 6 个问题变成可执行清单
    计划第 7 节的 6 个问题此前只是「需要你确认」的罗列，无法直接用。新增
    working-docs/hardware-open-questions.md（267 行）：
    - A. 发给供应商的 24 问，分 5 组（协议与物理层 5 / 寄存器表 6 / 读数与保护 6 /
    机械 5 / 采购一致性 2），每条附「为什么需要」与「通过标准」。
    A6 是一段可直接复制粘贴的纯文本提问稿（编号 1-24 连续，已脚本校验）。
    - B. 5 项自查决策项（主板 / 连接板 / MVP 目标 / 训练资源 / 15 舵机），
    每项给出「选项 → 解锁什么 / 代价是什么」。
    -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
2026-09-20 新增 Zero 3W bring-up 日志：主板定案 RK3566 原板，基线验证通过，B1 结案
2026-09-20 新增 Radxa Zero 3W 产品资料（原理图/2D/3D CAD/产品简介）
2026-09-20 gitignore: 排除本地参考仓库 microduck-replica（fanhao375 复刻仓）
2026-09-20 gitignore: elec_RPI_Robot_HAT 改为本地参考副本，不纳入版本管理
    仅本地参考上游 pollen-robotics/elec_RPI_Robot_HAT，不修改其内容，
    与 microduck-replica 处理方式一致。需更新时在该目录内直接 git pull。
2026-09-20 嘉立创下单包：elec_RPI_Robot_HAT C1 批次 Gerber/BOM/坐标
    来源为本地参考副本 elec_RPI_Robot_HAT/production（上游 C1 量产文件）。
    BOM 按国内站(jlc.com)规范修正：移除 9 个 DNP 位号与铜层 logo H2、
    列名改为 Comment/Designator/Footprint/JLCPCB Part #、去除 BOM 头、
    欧洲小数逗号改为点号。Gerber 与坐标文件与上游逐字节一致。
    详见 README.md。
    [elec_RPI_Robot_HAT_BOM_jlc.csv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]
2026-09-20 三个上游 checkout 收进 reference/
    将 microduck-lab / microduck-replica / elec_RPI_Robot_HAT 移到 reference/ 下，
    统一为自包含的本地参考副本（reference/ 整体 gitignore）。
    microduck-lab 由 submodule 改为普通克隆：把 .git/modules/microduck-lab 搬成
    reference/microduck-lab/.git，并清掉残留的 core.worktree；elec_RPI_Robot_HAT
    同样清掉此前 git rm --cached 遗留的外部 gitdir 指针。.gitmodules 已无内容。
    之前 decisions.md 记录的「不移动」约束实际约束的是 microduck-lab 内部四份并排
    checkout 的相互位置（microduck_local 按 ../microduck_rl 找模型），而非父目录。
    整体移动不改变任何一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
2026-09-20 新增飞特路线硬件采购清单（working-docs/hardware-shopping-list.md）
    按已购 / 舵机 / 电控必买 / 打样 / 机械 / 工具 / 不买 / 预算 / 下单顺序
    分节，价格与链接主要取自 reference/microduck-replica 的采购清单
    （2026-09-04 淘宝快照）。
    保留红线：Week 1 spike 通过前只持有 1 颗舵机，不批量下单。
    整机预算约 ¥1400–1900，约为 XL330 原版路线的 1/2–2/3。
2026-10-12 装配与首上电计划：HAT/imu_to_dxl 互连验证记录、板子标注图、09-26 台架数据入档、servo-debug 工具
2026-10-25 NP-F550 电池仓/触点对位模板与装配演示、Zero 控制台工具、舵机改 ID 工具及文档更新
