shenjin73/microduck-build/working-docs/board-photos/radxa-pin1-annotated.jpg

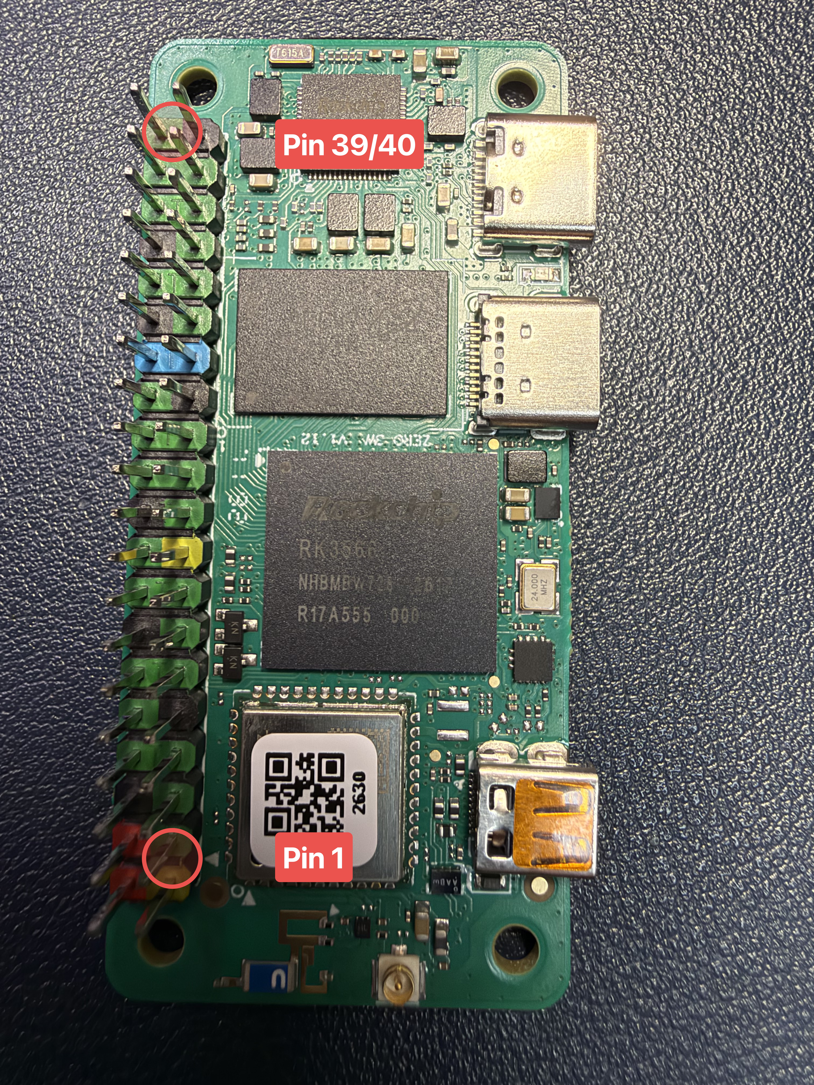
working-docs/board-photos/radxa-pin1-annotated.jpg
