shenjin73/microduck-build/working-docs/board-photos/imu2dxl-cn2-annotated.jpg

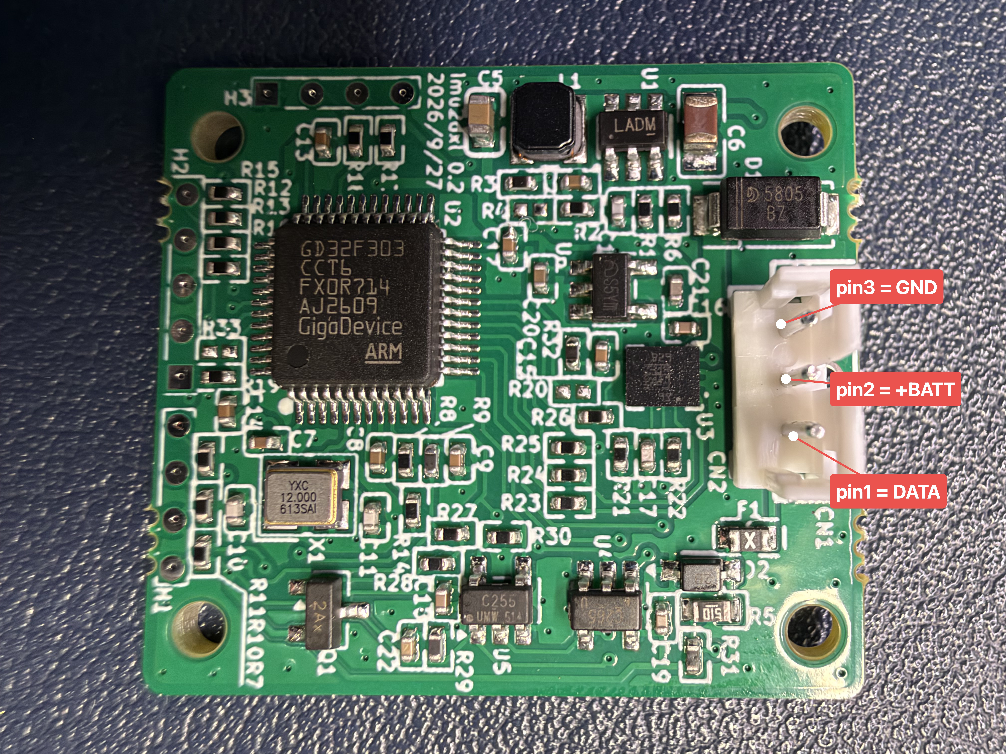
working-docs/board-photos/imu2dxl-cn2-annotated.jpg
