shenjin73/microduck-build/working-docs/board-photos/hat-connectors-annotated.jpg

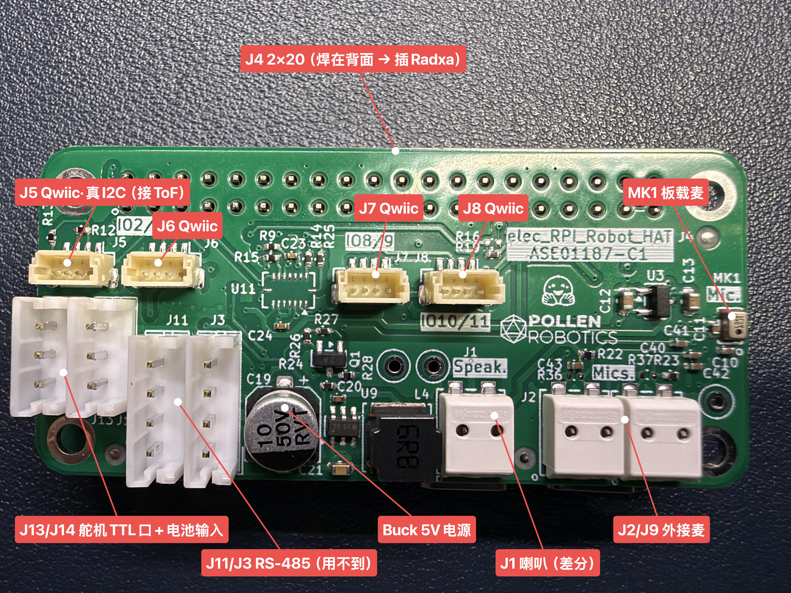
working-docs/board-photos/hat-connectors-annotated.jpg
